WolfNet-Computing/WolfNet-65C02-WBC/Debug.jpg

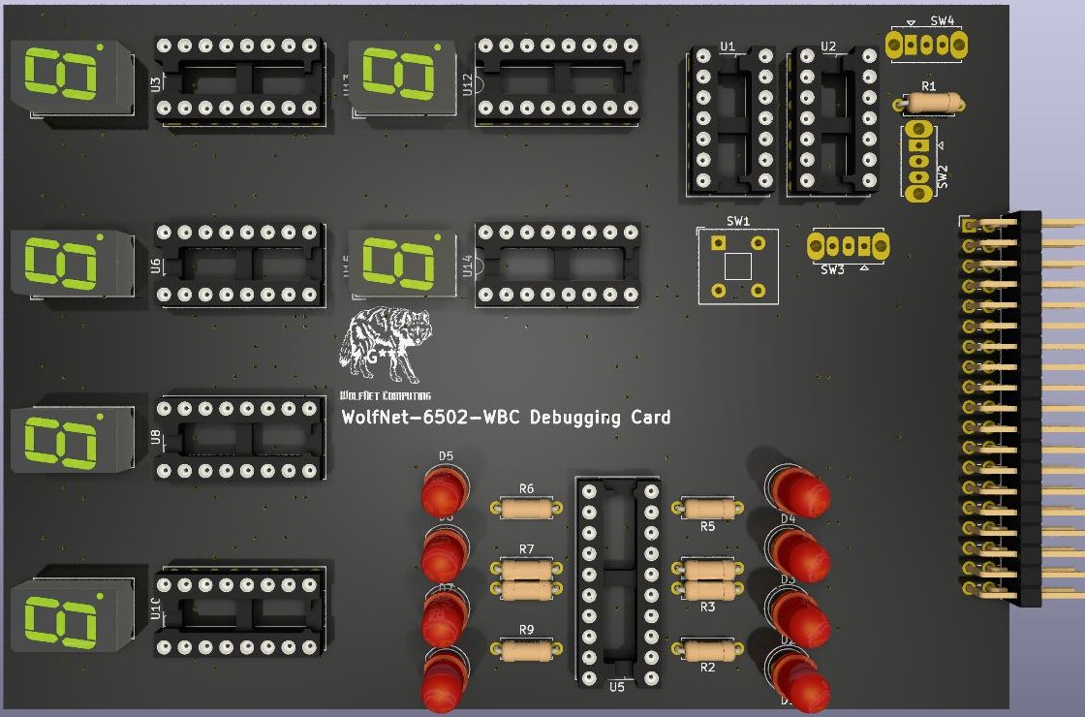
Debug.jpg
