WolfNet-Computing/WolfNet-65C02-WBC/Sound.jpg

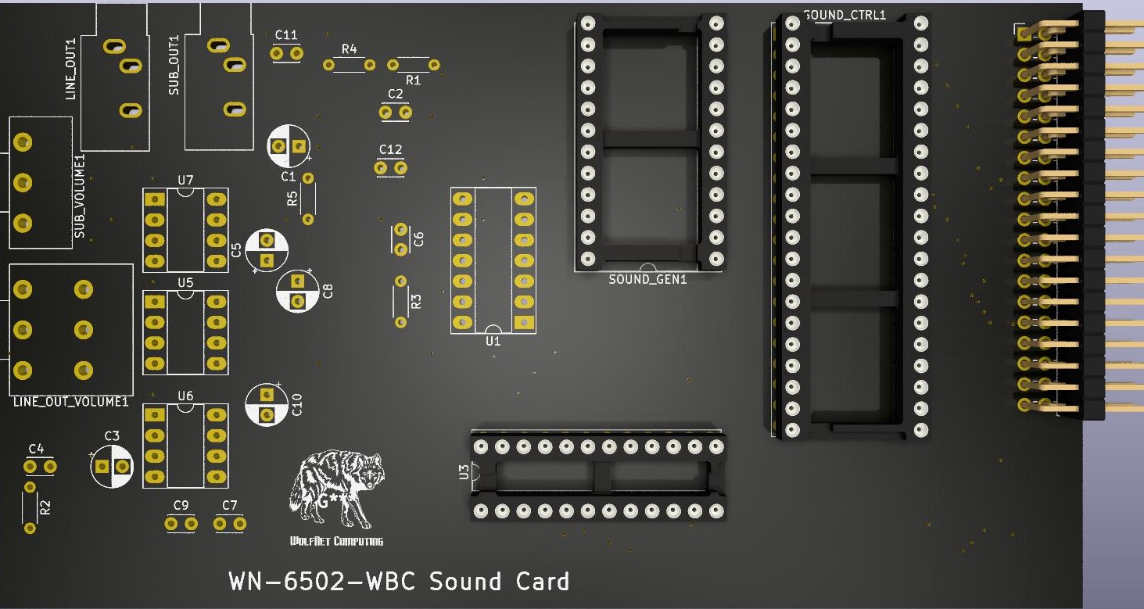
Sound.jpg
