WolfNet-Computing/WolfNet-65C02-WBC/README.md

[Pictures](./pictures.html)  
[Connector Pinouts](./pinouts.html)  
[Memory Map](./memory_map.html)  
[Thanks](./thanks.html)
