WolfNet-Computing/WolfNet-65C02-WBC/Motherboard.jpg

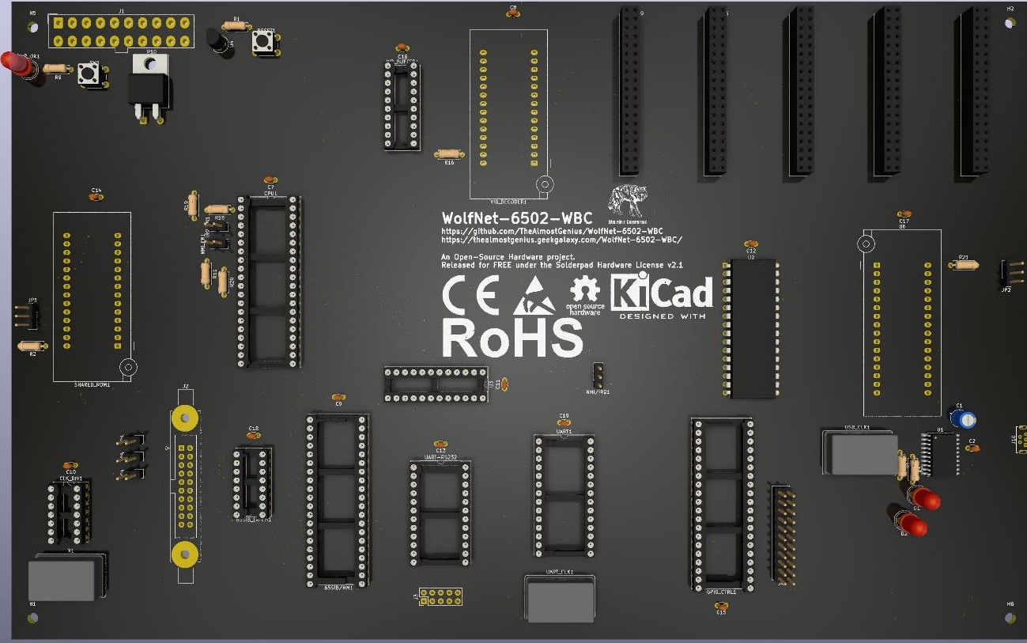
Motherboard.jpg
