WolfNet-Computing/WolfNet-65C02-WBC/Motherboard/Motherboard.kicad_pcb

## KiCad design Motherboard/Motherboard.kicad_pcb (2026-08-31)

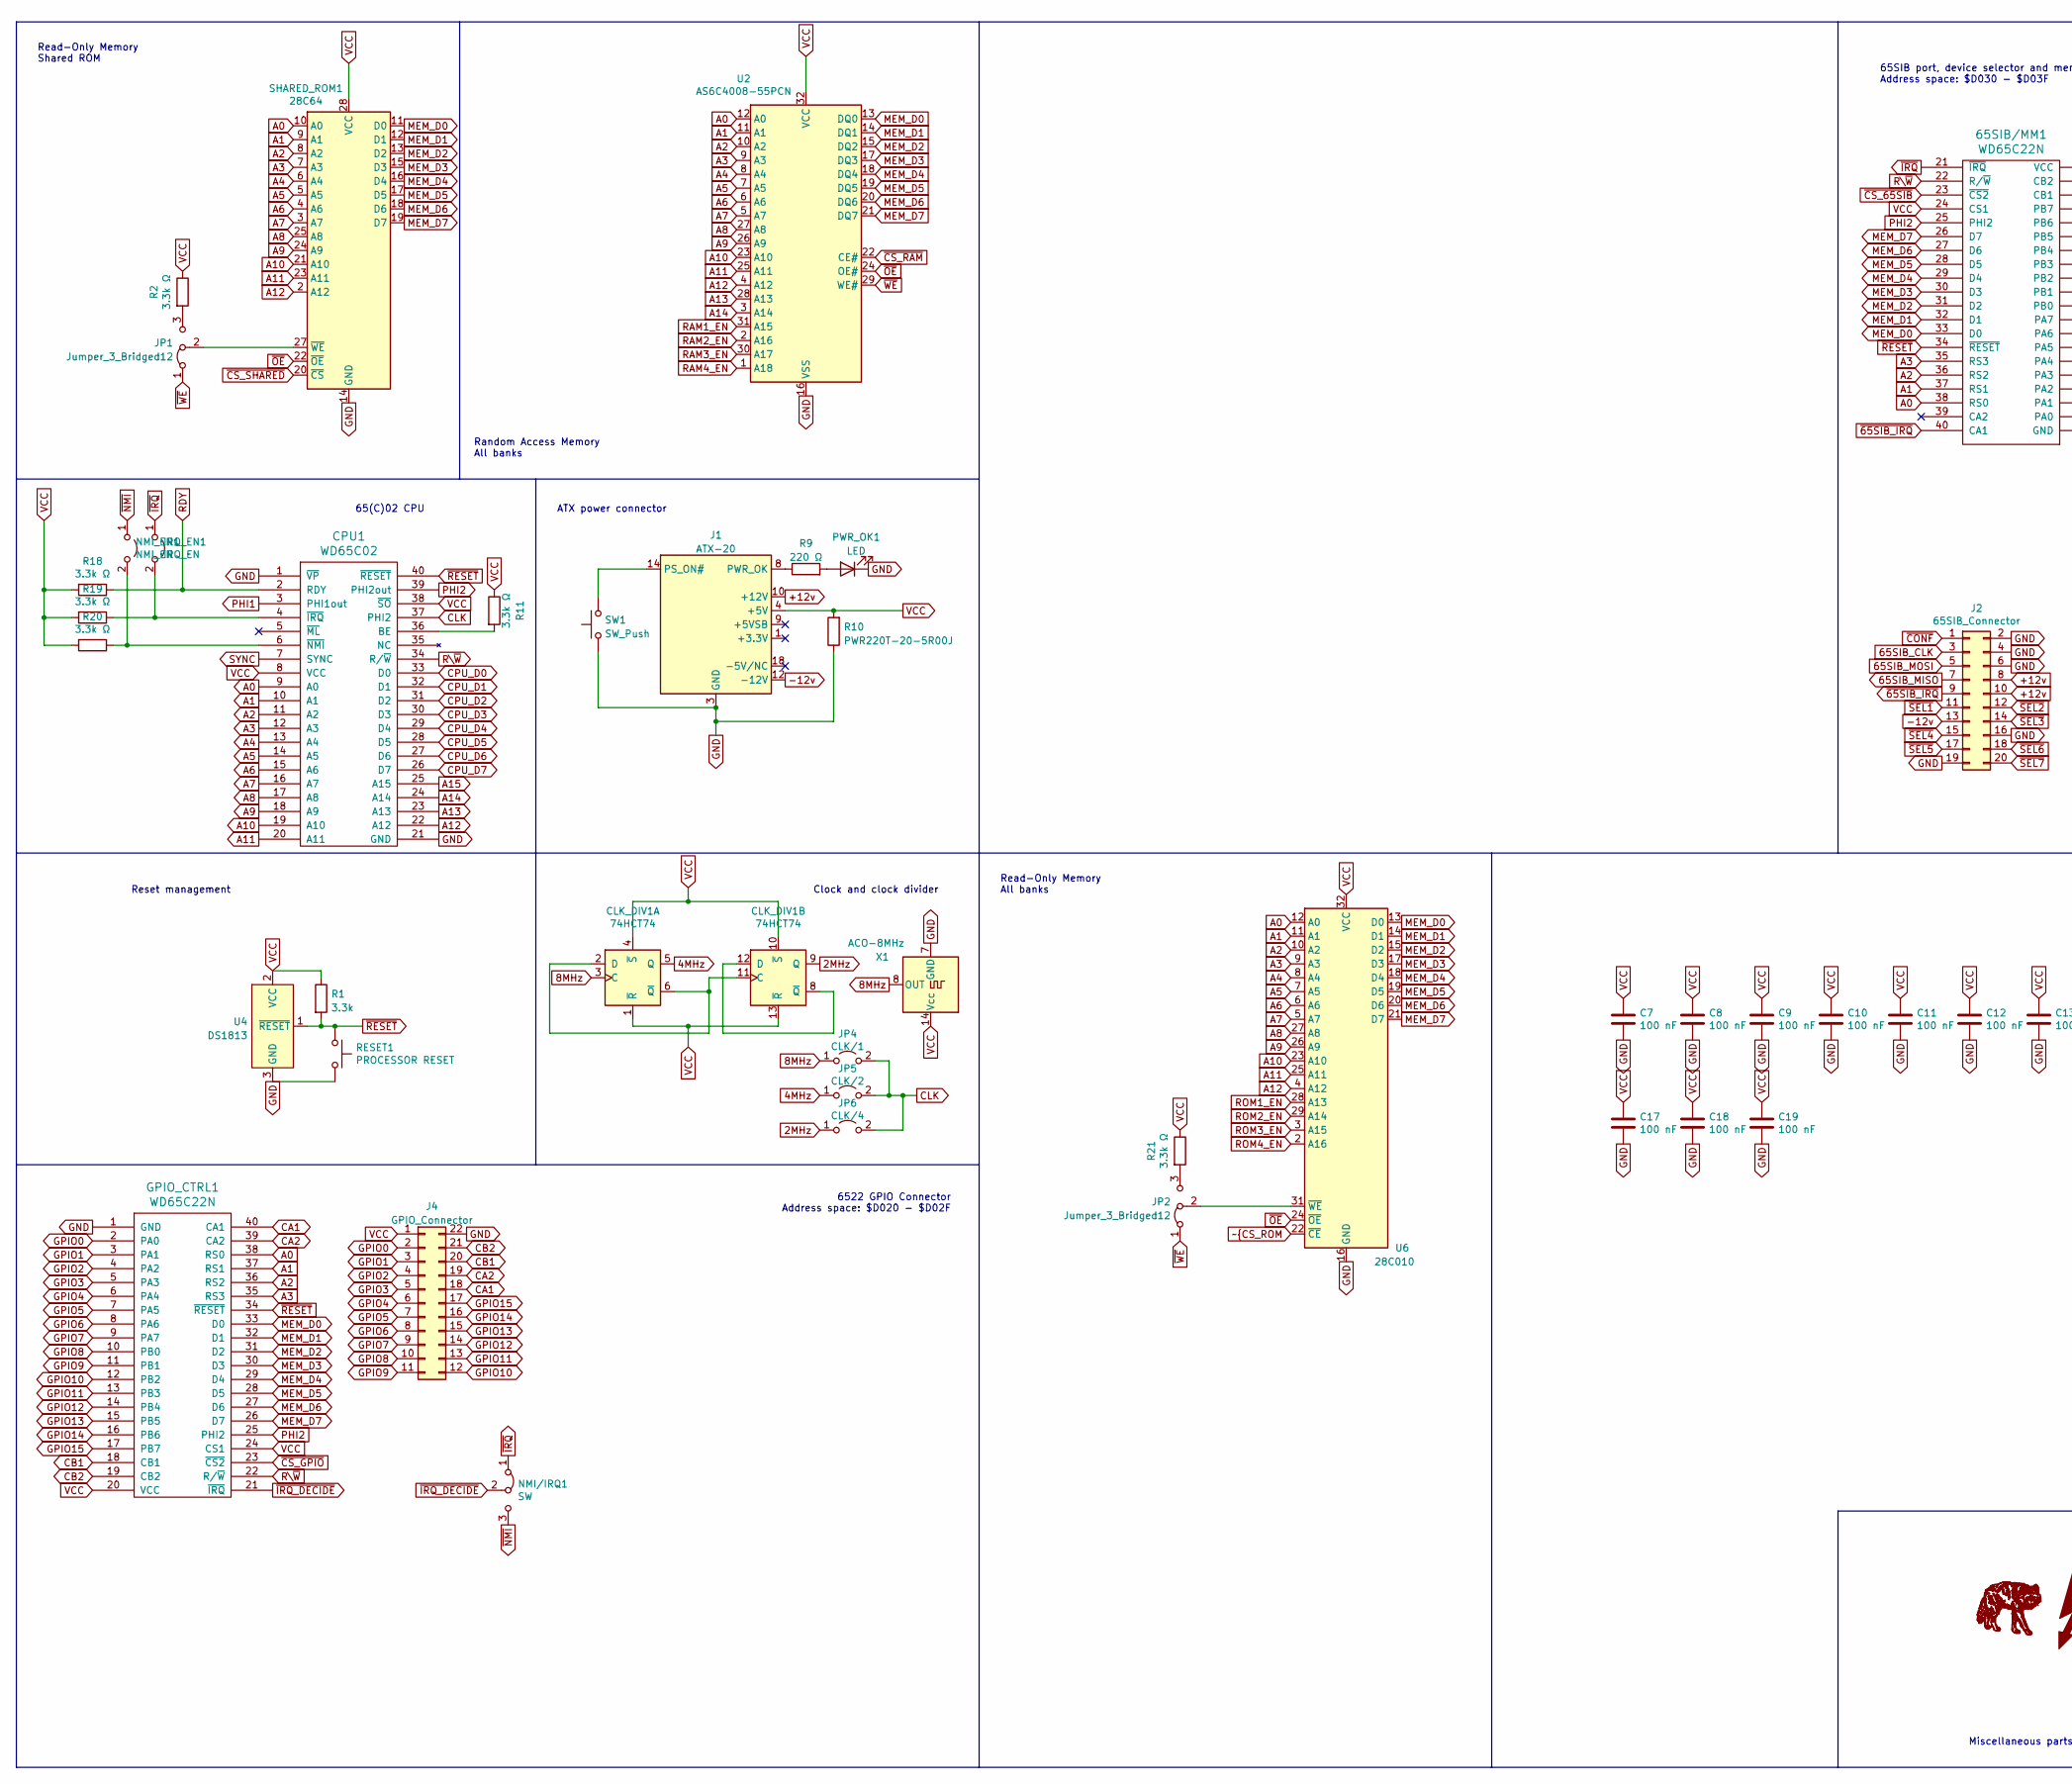
[picture p4: schematic Motherboard.kicad_sch, WolfNet 6502 WBC - Motherboard, part in row 1, column 1]

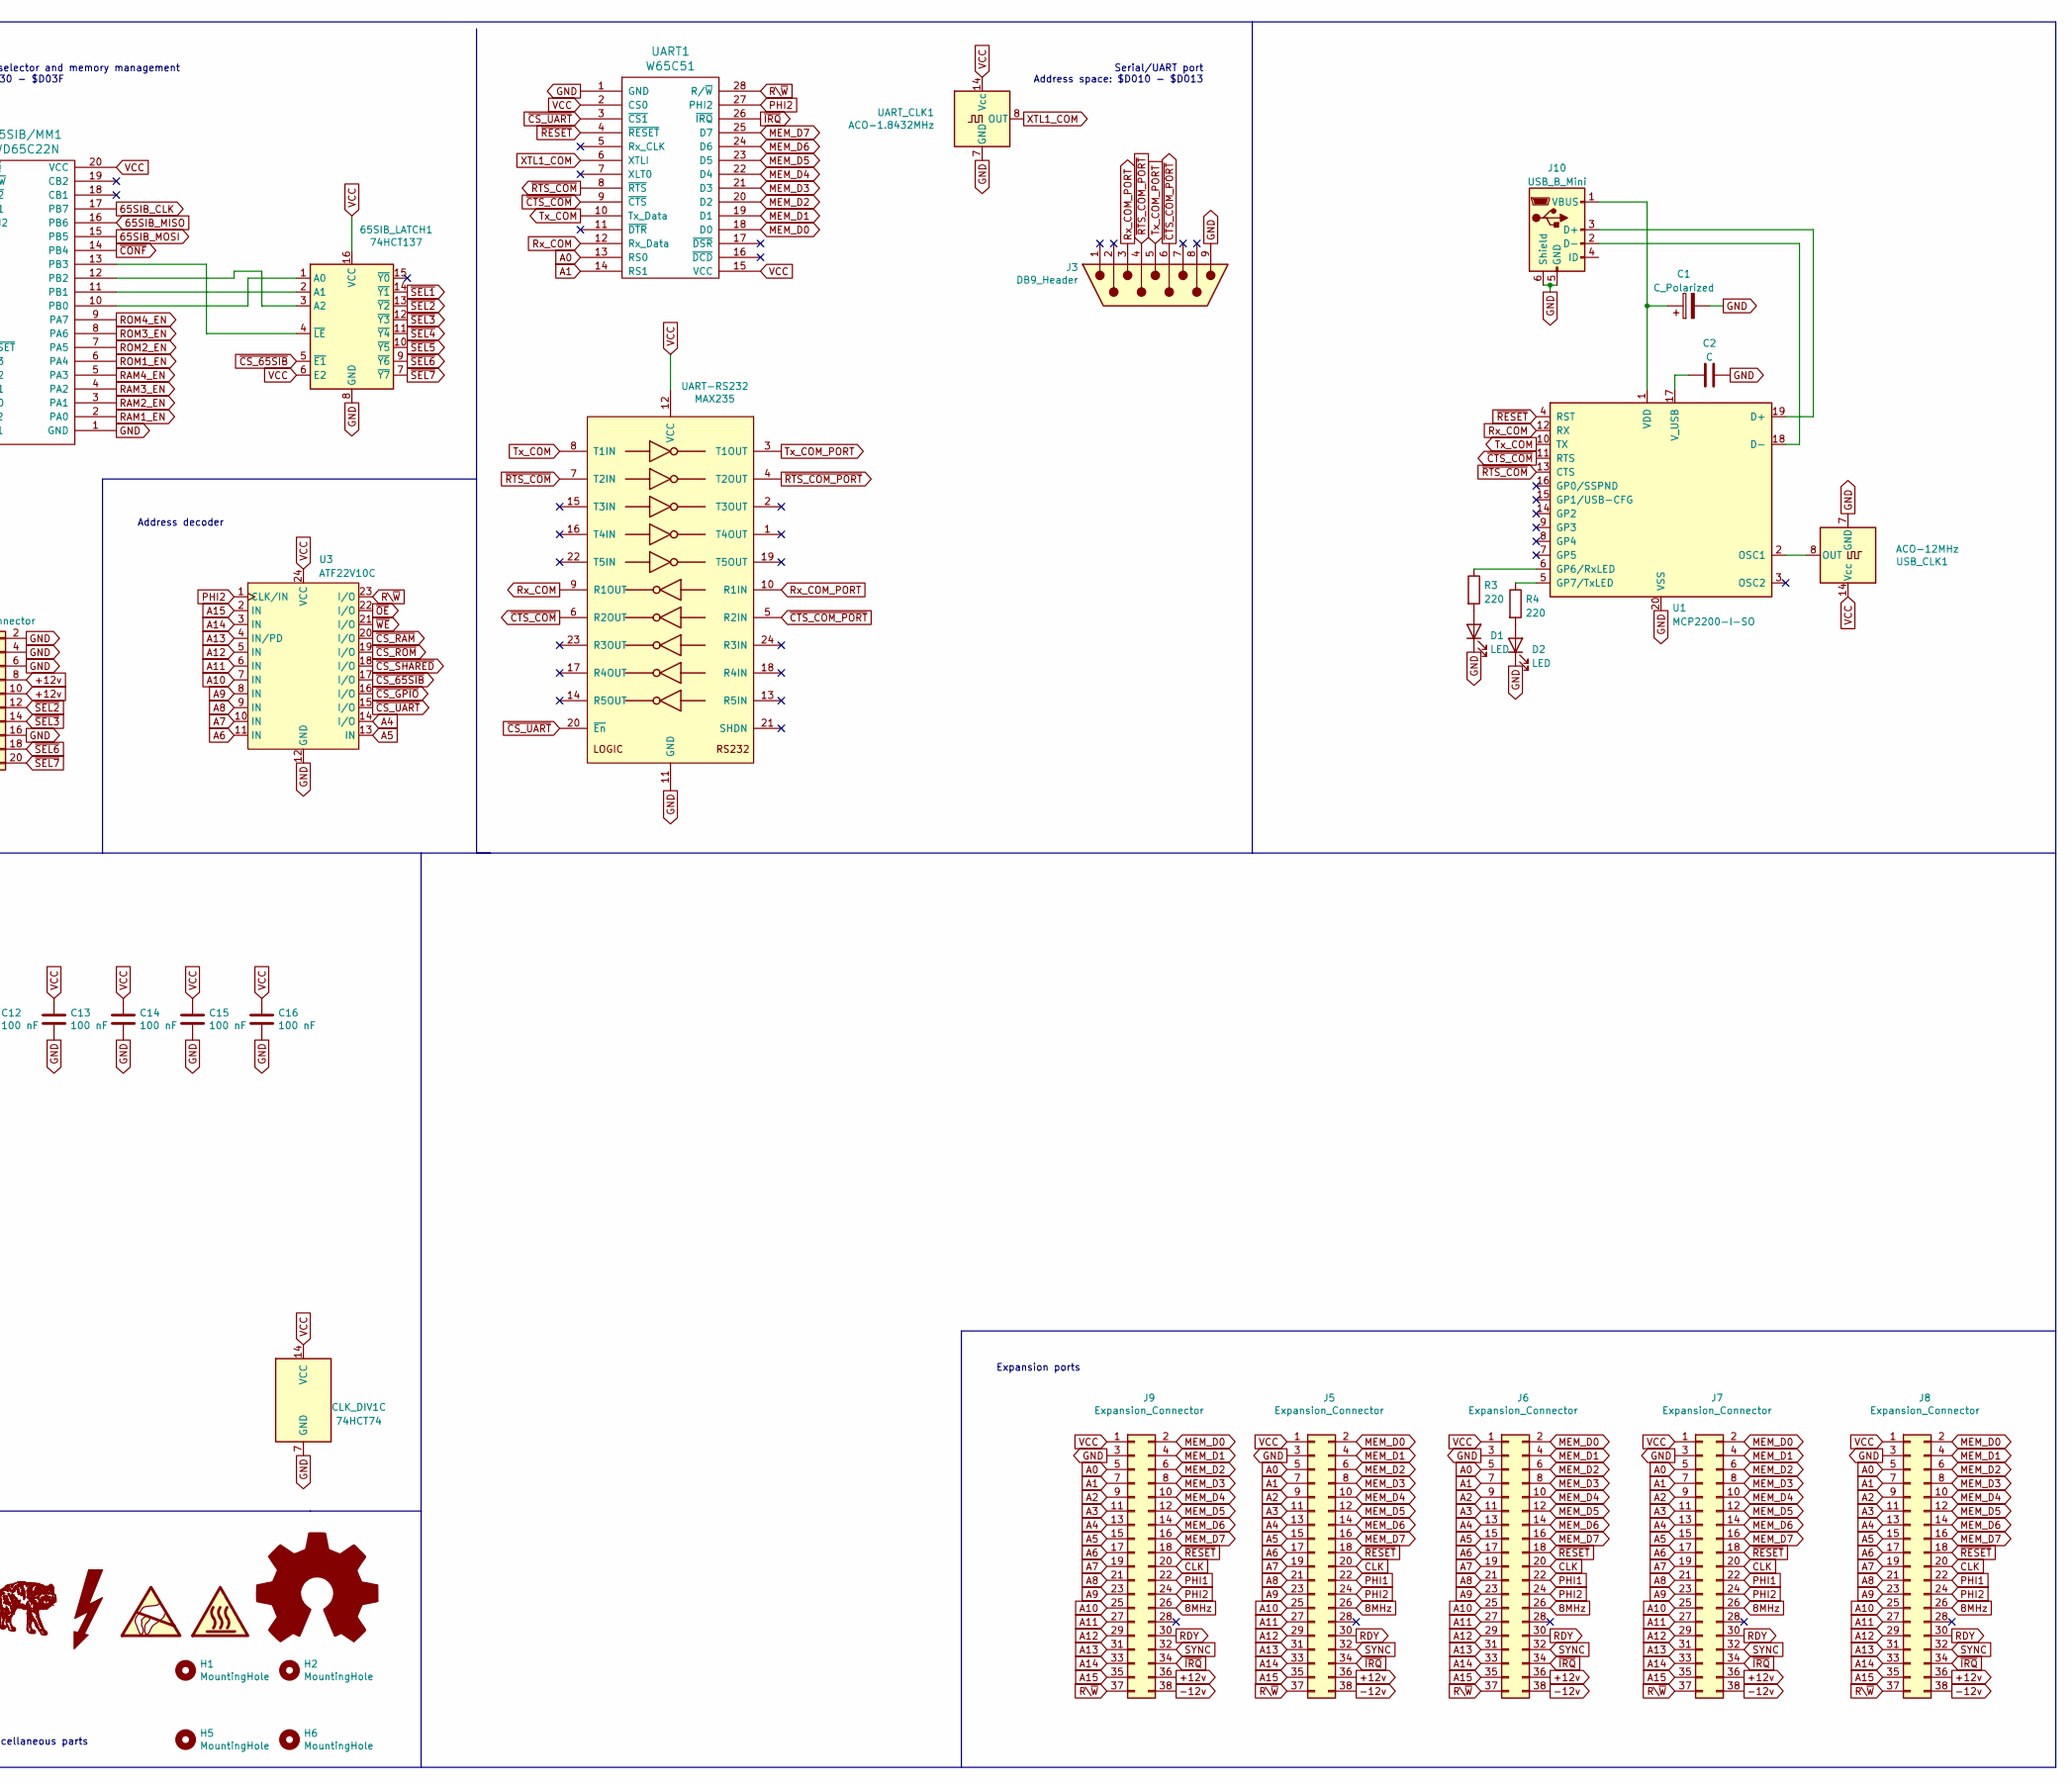
[picture p5: schematic Motherboard.kicad_sch, WolfNet 6502 WBC - Motherboard, part in row 1, column 2]

Parts:
65SIB/MM1: WD65C22N; DIP-40_W15.24mm_Socket_LongPads
65SIB_LATCH1: 74HCT137; DIP-16_W7.62mm_Socket_LongPads
C1: C_Polarized; CP_Radial_D5.0mm_P2.50mm
C2: C; C_Disc_D3.0mm_W1.6mm_P2.50mm
C7, C8, C9, C10, C11, C12, C13, C14, C15, C16, C17, C18, C19: 100 nF; C_Disc_D3.0mm_W1.6mm_P2.50mm
CLK_DIV1: 74HCT74; DIP-14_W7.62mm_Socket_LongPads
CPU1: WD65C02; DIP-40_W15.24mm_Socket_LongPads
D1, D2: LED; LED_D5.0mm
GPIO_CTRL1: WD65C22N; DIP-40_W15.24mm_Socket_LongPads
H1, H2, H5, H6: MountingHole; MountingHole_3.2mm_M3
IRQ_EN1: IRQ_EN; PinHeader_1x02_P2.54mm_Vertical
J1: ATX-20; Molex_Mini-Fit_Jr_5566-20A_2x10_P4.20mm_Vertical
J2: 65SIB_Connector; IDC-Header_2x10-1MP_P2.54mm_Latch6.5mm_Vertical
J3: DB9_Header
J4: GPIO_Connector; PinHeader_2x11_P2.54mm_Vertical
J5, J6, J7, J8, J9: Expansion_Connector; Expansion_Connector_Motherboard
J10: USB_B_Mini; USB_Mini-B_Tensility_54-00023_Vertical
JP1, JP2: Jumper_3_Bridged12; PinHeader_1x03_P2.54mm_Vertical
JP4: CLK/1; PinHeader_1x02_P2.54mm_Vertical
JP5: CLK/2; PinHeader_1x02_P2.54mm_Vertical
JP6: CLK/4; PinHeader_1x02_P2.54mm_Vertical
NMI/IRQ1: SW; PinHeader_1x03_P2.54mm_Vertical
NMI_EN1: NMI_EN; PinHeader_1x02_P2.54mm_Vertical
PWR_OK1: LED; LED_D5.0mm
R1: 3.3k; R_Axial_DIN0207_L6.3mm_D2.5mm_P7.62mm_Horizontal
R2, R11, R18, R19, R20, R21: 3.3k Ω; R_Axial_DIN0207_L6.3mm_D2.5mm_P7.62mm_Horizontal
R3, R4: 220; R_Axial_DIN0207_L6.3mm_D2.5mm_P7.62mm_Horizontal
R9: 220 Ω; R_Axial_DIN0207_L6.3mm_D2.5mm_P7.62mm_Horizontal
R10: PWR220T-20-5R00J; TO-220-2_Horizontal_TabDown
RESET1: PROCESSOR RESET; SW_PUSH_6mm_H4.3mm
SHARED_ROM1: 28C64; DIP_Socket-28_W11.9_W12.7_W15.24_W17.78_W18.5_3M_228-1277-0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
SW1: SW_Push; SW_PUSH_6mm
U1: MCP2200-I-SO; SOIC-20W_7.5x12.8mm_P1.27mm
U2: AS6C4008-55PCN; DIP-32_W15.24mm
U3: ATF22V10C; DIP-24_W7.62mm_Socket_LongPads
U4: DS1813; TO-92
U6: 28C010; DIP_Socket-32_W11.9_W12.7_W15.24_W17.78_W18.5_3M_232-1285-0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
UART1: W65C51; DIP-28_W15.24mm_Socket_LongPads
UART-RS232: MAX235; DIP-24_W15.24mm_Socket_LongPads
UART_CLK1: ACO-1.8432MHz; Oscillator_DIP-14
USB_CLK1: ACO-12MHz; Oscillator_DIP-14
X1: ACO-8MHz; Oscillator_DIP-14

Connections:
2MHz: CLK_DIV1.9 (Q), JP6.1 (A)
4MHz: CLK_DIV1.5 (Q), JP5.1 (A)
8MHz: CLK_DIV1.3 (C), J5.26, J6.26, J7.26, J8.26, J9.26, JP4.1 (A), X1.8 (OUT)
65SIB_CLK: 65SIB/MM1.17 (PB7), J2.3 (CLK)
65SIB_MISO: 65SIB/MM1.16 (PB6), J2.7 (MISO)
65SIB_MOSI: 65SIB/MM1.15 (PB5), J2.5 (MOSI)
+12v: J1.10 (+12V), J2.8 (12v), J2.10 (12v), J5.36, J6.36, J7.36, J8.36, J9.36
-12v: J1.12 (-12V), J2.13 (-12v), J5.38, J6.38, J7.38, J8.38, J9.38
A0: 65SIB/MM1.38 (RS0), CPU1.9 (A0), GPIO_CTRL1.38 (RS0), J5.5, J6.5, J7.5, J8.5, J9.5, SHARED_ROM1.10 (A0), U2.12 (A0), U6.12 (A0), UART1.13 (RS0)
A1: 65SIB/MM1.37 (RS1), CPU1.10 (A1), GPIO_CTRL1.37 (RS1), J5.7, J6.7, J7.7, J8.7, J9.7, SHARED_ROM1.9 (A1), U2.11 (A1), U6.11 (A1), UART1.14 (RS1)
A2: 65SIB/MM1.36 (RS2), CPU1.11 (A2), GPIO_CTRL1.36 (RS2), J5.9, J6.9, J7.9, J8.9, J9.9, SHARED_ROM1.8 (A2), U2.10 (A2), U6.10 (A2)
A3: 65SIB/MM1.35 (RS3), CPU1.12 (A3), GPIO_CTRL1.35 (RS3), J5.11, J6.11, J7.11, J8.11, J9.11, SHARED_ROM1.7 (A3), U2.9 (A3), U6.9 (A3)
A4: CPU1.13 (A4), J5.13, J6.13, J7.13, J8.13, J9.13, SHARED_ROM1.6 (A4), U2.8 (A4), U3.14 (I/O), U6.8 (A4)
A5: CPU1.14 (A5), J5.15, J6.15, J7.15, J8.15, J9.15, SHARED_ROM1.5 (A5), U2.7 (A5), U3.13 (IN), U6.7 (A5)
A6: CPU1.15 (A6), J5.17, J6.17, J7.17, J8.17, J9.17, SHARED_ROM1.4 (A6), U2.6 (A6), U3.11 (IN), U6.6 (A6)
A7: CPU1.16 (A7), J5.19, J6.19, J7.19, J8.19, J9.19, SHARED_ROM1.3 (A7), U2.5 (A7), U3.10 (IN), U6.5 (A7)
A8: CPU1.17 (A8), J5.21, J6.21, J7.21, J8.21, J9.21, SHARED_ROM1.25 (A8), U2.27 (A8), U3.9 (IN), U6.27 (A8)
A9: CPU1.18 (A9), J5.23, J6.23, J7.23, J8.23, J9.23, SHARED_ROM1.24 (A9), U2.26 (A9), U3.8 (IN), U6.26 (A9)
A10: CPU1.19 (A10), J5.25, J6.25, J7.25, J8.25, J9.25, SHARED_ROM1.21 (A10), U2.23 (A10), U3.7 (IN), U6.23 (A10)
A11: CPU1.20 (A11), J5.27, J6.27, J7.27, J8.27, J9.27, SHARED_ROM1.23 (A11), U2.25 (A11), U3.6 (IN), U6.25 (A11)
A12: CPU1.22 (A12), J5.29, J6.29, J7.29, J8.29, J9.29, SHARED_ROM1.2 (A12), U2.4 (A12), U3.5 (IN), U6.4 (A12)
A13: CPU1.23 (A13), J5.31, J6.31, J7.31, J8.31, J9.31, U2.28 (A13), U3.4 (IN/PD)
A14: CPU1.24 (A14), J5.33, J6.33, J7.33, J8.33, J9.33, U2.3 (A14), U3.3 (IN)
A15: CPU1.25 (A15), J5.35, J6.35, J7.35, J8.35, J9.35, U3.2 (IN)
CA1: GPIO_CTRL1.40 (CA1), J4.18
CA2: GPIO_CTRL1.39 (CA2), J4.19
CB1: GPIO_CTRL1.18 (CB1), J4.20
CB2: GPIO_CTRL1.19 (CB2), J4.21
CLK: CPU1.37 (PHI2), J5.20, J6.20, J7.20, J8.20, J9.20, JP4.2 (B), JP5.2 (B), JP6.2 (B)
CPU_D0: CPU1.33 (D0)
CPU_D1: CPU1.32 (D1)
CPU_D2: CPU1.31 (D2)
CPU_D3: CPU1.30 (D3)
CPU_D4: CPU1.29 (D4)
CPU_D5: CPU1.28 (D5)
CPU_D6: CPU1.27 (D6)
CPU_D7: CPU1.26 (D7)
GND: 65SIB/MM1.1 (GND), 65SIB_LATCH1.8 (GND), C1.2, C2.2, C7.2, C8.2, C9.2, C10.2, C11.2, C12.2, C13.2, C14.2, C15.2, C16.2, C17.2, C18.2, C19.2, CLK_DIV1.7 (GND), CPU1.1 (~VP), CPU1.21 (GND), D1.1 (K), D2.1 (K), GPIO_CTRL1.1 (GND), J1.3 (GND), J1.5 (GND), J1.7 (GND), J1.13 (GND), J1.15 (GND), J1.16 (GND), J1.17 (GND), J2.2 (GND), J2.4 (GND), J2.6 (eGND), J2.16 (GND), J2.19 (GND), J3.9 (5), J4.22, J5.3, J6.3, J7.3, J8.3, J9.3, J10.5 (GND), J10.6 (Shield), PWR_OK1.1 (K), R10.1, RESET1.2, SHARED_ROM1.14 (GND), SW1.1, U1.20 (VSS), U2.16 (VSS), U3.12 (GND), U4.3 (GND), U6.16 (GND), UART1.1 (GND), UART-RS232.11 (GND), UART_CLK1.7 (GND), USB_CLK1.7 (GND), X1.7 (GND)
GPIO0: GPIO_CTRL1.2 (PA0), J4.2
GPIO1: GPIO_CTRL1.3 (PA1), J4.3
GPIO2: GPIO_CTRL1.4 (PA2), J4.4
GPIO3: GPIO_CTRL1.5 (PA3), J4.5
GPIO4: GPIO_CTRL1.6 (PA4), J4.6
GPIO5: GPIO_CTRL1.7 (PA5), J4.7
GPIO6: GPIO_CTRL1.8 (PA6), J4.8
GPIO7: GPIO_CTRL1.9 (PA7), J4.9
GPIO8: GPIO_CTRL1.10 (PB0), J4.10
GPIO9: GPIO_CTRL1.11 (PB1), J4.11
GPIO10: GPIO_CTRL1.12 (PB2), J4.12
GPIO11: GPIO_CTRL1.13 (PB3), J4.13
GPIO12: GPIO_CTRL1.14 (PB4), J4.14
GPIO13: GPIO_CTRL1.15 (PB5), J4.15
GPIO14: GPIO_CTRL1.16 (PB6), J4.16
GPIO15: GPIO_CTRL1.17 (PB7), J4.17
MEM_D0: 65SIB/MM1.33 (D0), GPIO_CTRL1.33 (D0), J5.2, J6.2, J7.2, J8.2, J9.2, SHARED_ROM1.11 (D0), U2.13 (DQ0), U6.13 (D0), UART1.18 (D0)
MEM_D1: 65SIB/MM1.32 (D1), GPIO_CTRL1.32 (D1), J5.4, J6.4, J7.4, J8.4, J9.4, SHARED_ROM1.12 (D1), U2.14 (DQ1), U6.14 (D1), UART1.19 (D1)
MEM_D2: 65SIB/MM1.31 (D2), GPIO_CTRL1.31 (D2), J5.6, J6.6, J7.6, J8.6, J9.6, SHARED_ROM1.13 (D2), U2.15 (DQ2), U6.15 (D2), UART1.20 (D2)
MEM_D3: 65SIB/MM1.30 (D3), GPIO_CTRL1.30 (D3), J5.8, J6.8, J7.8, J8.8, J9.8, SHARED_ROM1.15 (D3), U2.17 (DQ3), U6.17 (D3), UART1.21 (D3)
MEM_D4: 65SIB/MM1.29 (D4), GPIO_CTRL1.29 (D4), J5.10, J6.10, J7.10, J8.10, J9.10, SHARED_ROM1.16 (D4), U2.18 (DQ4), U6.18 (D4), UART1.22 (D4)
MEM_D5: 65SIB/MM1.28 (D5), GPIO_CTRL1.28 (D5), J5.12, J6.12, J7.12, J8.12, J9.12, SHARED_ROM1.17 (D5), U2.19 (DQ5), U6.19 (D5), UART1.23 (D5)
MEM_D6: 65SIB/MM1.27 (D6), GPIO_CTRL1.27 (D6), J5.14, J6.14, J7.14, J8.14, J9.14, SHARED_ROM1.18 (D6), U2.20 (DQ6), U6.20 (D6), UART1.24 (D6)
MEM_D7: 65SIB/MM1.26 (D7), GPIO_CTRL1.26 (D7), J5.16, J6.16, J7.16, J8.16, J9.16, SHARED_ROM1.19 (D7), U2.21 (DQ7), U6.21 (D7), UART1.25 (D7)
unnamed: 65SIB/MM1.10 (PB0), 65SIB_LATCH1.1 (A0)
unnamed: 65SIB/MM1.11 (PB1), 65SIB_LATCH1.2 (A1)
unnamed: 65SIB/MM1.12 (PB2), 65SIB_LATCH1.3 (A2)
unnamed: 65SIB/MM1.13 (PB3), 65SIB_LATCH1.4 (~LE)
unnamed: CLK_DIV1.2 (D), CLK_DIV1.6 (~Q), CLK_DIV1.11 (C)
unnamed: CLK_DIV1.8 (~Q), CLK_DIV1.12 (D)
unnamed: CPU1.36 (BE), R11.2
unnamed: CPU1.4 (~IRQ), IRQ_EN1.2 (B), R19.1
unnamed: CPU1.6 (~NMI), NMI_EN1.2 (B), R20.1
unnamed: D1.2 (A), R3.2
unnamed: D2.2 (A), R4.2
unnamed: J1.14 (PS_ON#), SW1.2
unnamed: J1.8 (PWR_OK), R9.1
unnamed: J10.3 (D+), U1.19 (D+)
unnamed: J10.2 (D-), U1.18 (D-)
unnamed: C1.1, J10.1 (VBUS), U1.1 (VDD)
unnamed: JP1.3 (B), R2.2
unnamed: JP1.2 (C), SHARED_ROM1.27 (~WE)
unnamed: JP2.3 (B), R21.2
unnamed: JP2.2 (C), U6.31 (~WE)
unnamed: PWR_OK1.2 (A), R9.2
unnamed: R3.1, U1.6 (GP6/RxLED)
unnamed: R4.1, U1.5 (GP7/TxLED)
unnamed: U1.2 (OSC1), USB_CLK1.8 (OUT)
unnamed: C2.1, U1.17 (V_USB)
PHI1: CPU1.3 (PHI1out), J5.22, J6.22, J7.22, J8.22, J9.22
PHI2: 65SIB/MM1.25 (PHI2), CPU1.39 (PHI2out), GPIO_CTRL1.25 (PHI2), J5.24, J6.24, J7.24, J8.24, J9.24, U3.1 (CLK/IN), UART1.27 (PHI2)
RAM1_EN: 65SIB/MM1.2 (PA0), U2.31 (A15)
RAM2_EN: 65SIB/MM1.3 (PA1), U2.2 (A16)
RAM3_EN: 65SIB/MM1.4 (PA2), U2.30 (A17)
RAM4_EN: 65SIB/MM1.5 (PA3), U2.1 (A18)
RDY: CPU1.2 (RDY), J5.30, J6.30, J7.30, J8.30, J9.30, R18.1
ROM1_EN: 65SIB/MM1.6 (PA4), U6.28 (A13)
ROM2_EN: 65SIB/MM1.7 (PA5), U6.29 (A14)
ROM3_EN: 65SIB/MM1.8 (PA6), U6.3 (A15)
ROM4_EN: 65SIB/MM1.9 (PA7), U6.2 (A16)
R\~W: 65SIB/MM1.22 (R/~W), CPU1.34 (R/~W), GPIO_CTRL1.22 (R/~W), J5.37, J6.37, J7.37, J8.37, J9.37, U3.23 (I/O), UART1.28 (R/~W)
Rx_COM: U1.12 (RX), UART1.12 (Rx_Data), UART-RS232.9 (R1OUT)
Rx_COM_PORT: J3.3 (2), UART-RS232.10 (R1IN)
SYNC: CPU1.7 (SYNC), J5.32, J6.32, J7.32, J8.32, J9.32
Tx_COM: U1.10 (TX), UART1.10 (Tx_Data), UART-RS232.8 (T1IN)
Tx_COM_PORT: J3.5 (3), UART-RS232.3 (T1OUT)
VCC: 65SIB/MM1.20 (VCC), 65SIB/MM1.24 (CS1), 65SIB_LATCH1.6 (E2), 65SIB_LATCH1.16 (VCC), C7.1, C8.1, C9.1, C10.1, C11.1, C12.1, C13.1, C14.1, C15.1, C16.1, C17.1, C18.1, C19.1, CLK_DIV1.1 (~R), CLK_DIV1.4 (~S), CLK_DIV1.10 (~S), CLK_DIV1.13 (~R), CLK_DIV1.14 (VCC), CPU1.8 (VCC), CPU1.38 (~SO), GPIO_CTRL1.20 (VCC), GPIO_CTRL1.24 (CS1), J1.4 (+5V), J1.6 (+5V), J1.19 (+5V), J1.20 (+5V), J4.1, J5.1, J6.1, J7.1, J8.1, J9.1, R1.1, R2.1, R10.2, R11.1, R18.2, R19.2, R20.2, R21.1, SHARED_ROM1.28 (VCC), U2.32 (VCC), U3.24 (VCC), U4.2 (VCC), U6.32 (VCC), UART1.2 (CS0), UART1.15 (VCC), UART-RS232.12 (VCC), UART_CLK1.14 (Vcc), USB_CLK1.14 (Vcc), X1.14 (Vcc)
XTL1_COM: UART1.6 (XTLI), UART_CLK1.8 (OUT)
~65SIB_IRQ: 65SIB/MM1.40 (CA1), J2.9 (IRO\)
~CONF: 65SIB/MM1.14 (PB4), J2.1 (CONF\)
~CS_65SIB: 65SIB/MM1.23 (~CS2), 65SIB_LATCH1.5 (~E1), U3.17 (I/O)
~CS_GPIO: GPIO_CTRL1.23 (~CS2), U3.16 (I/O)
~CS_RAM: U2.22 (CE#), U3.20 (I/O)
~{CS_ROM: U6.22 (~CE)
~CS_ROM: U3.19 (I/O)
~CS_SHARED: SHARED_ROM1.20 (~CS), U3.18 (I/O)
~CS_UART: U3.15 (I/O), UART1.3 (~CS1), UART-RS232.20 (~En)
~CTS_COM_PORT: J3.6 (8), UART-RS232.5 (R2IN)
~CTS_COM: U1.11 (RTS), UART1.9 (~CTS), UART-RS232.6 (R2OUT)
~IRQ_DECIDE: GPIO_CTRL1.21 (~IRQ), NMI/IRQ1.2 (C)
~IRQ: 65SIB/MM1.21 (~IRQ), IRQ_EN1.1 (A), J5.34, J6.34, J7.34, J8.34, J9.34, NMI/IRQ1.1 (A), UART1.26 (~IRQ)
~NMI: NMI/IRQ1.3 (B), NMI_EN1.1 (A)
~OE: SHARED_ROM1.22 (~OE), U2.24 (OE#), U3.22 (I/O), U6.24 (~OE)
~RESET: 65SIB/MM1.34 (~RESET), CPU1.40 (~RESET), GPIO_CTRL1.34 (~RESET), J5.18, J6.18, J7.18, J8.18, J9.18, R1.2, RESET1.1, U1.4 (RST), U4.1 (~RESET), UART1.4 (~RESET)
~RTS_COM_PORT: J3.4 (7), UART-RS232.4 (T2OUT)
~RTS_COM: U1.13 (CTS), UART1.8 (~RTS), UART-RS232.7 (T2IN)
~SEL1: 65SIB_LATCH1.14 (~Y1), J2.11 (SEL1\)
~SEL2: 65SIB_LATCH1.13 (~Y2), J2.12 (SEL2\)
~SEL3: 65SIB_LATCH1.12 (~Y3), J2.14 (SEL3\)
~SEL4: 65SIB_LATCH1.11 (~Y4), J2.15 (SEL4\)
~SEL5: 65SIB_LATCH1.10 (~Y5), J2.17 (SEL5\)
~SEL6: 65SIB_LATCH1.9 (~Y6), J2.18 (SEL6\)
~SEL7: 65SIB_LATCH1.7 (~Y7), J2.20 (SEL7\)
~WE: JP1.1 (A), JP2.1 (A), U2.29 (WE#), U3.21 (I/O)

Notes on the sheet:
ATX power connector
Expansion ports
Clock and clock divider
Miscellaneous parts
Serial/UART port Address space: $D010 - $D013
65(C)02 CPU
65SIB port, device selector and memory management Address space: $D030 - $D03F
Read-Only Memory All banks
Read-Only Memory Shared ROM
6522 GPIO Connector Address space: $D020 - $D02F
Random Access Memory All banks
Reset management
Address decoder

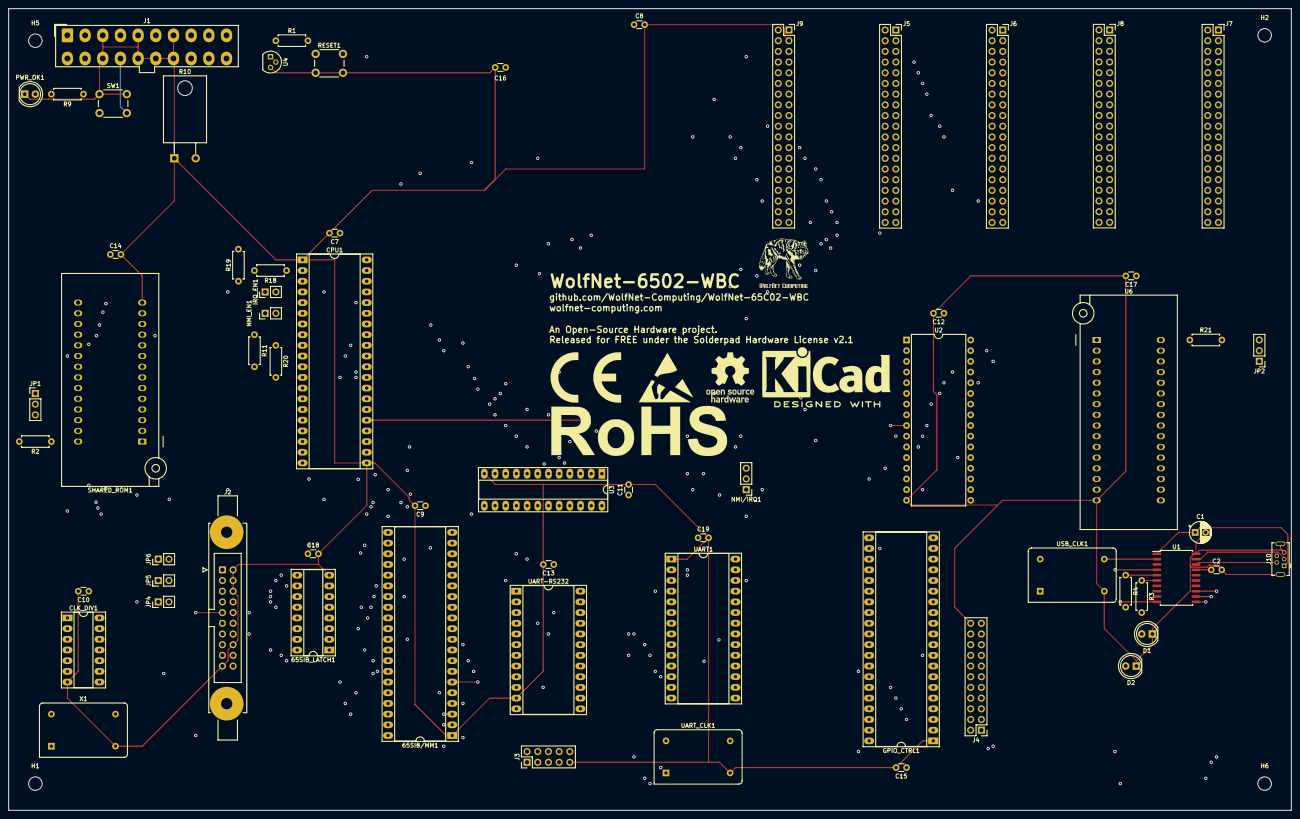
[picture p6: board Motherboard.kicad_pcb from above]

Board: 8 copper layers, 304.8 x 190.5 mm, 69 parts (0 on the bottom side), 122 nets.
