WolfNet-Computing/WolfNet-65C02-WBC/Sound/Sound.kicad_pcb

## KiCad design Sound/Sound.kicad_pcb (2026-08-31)

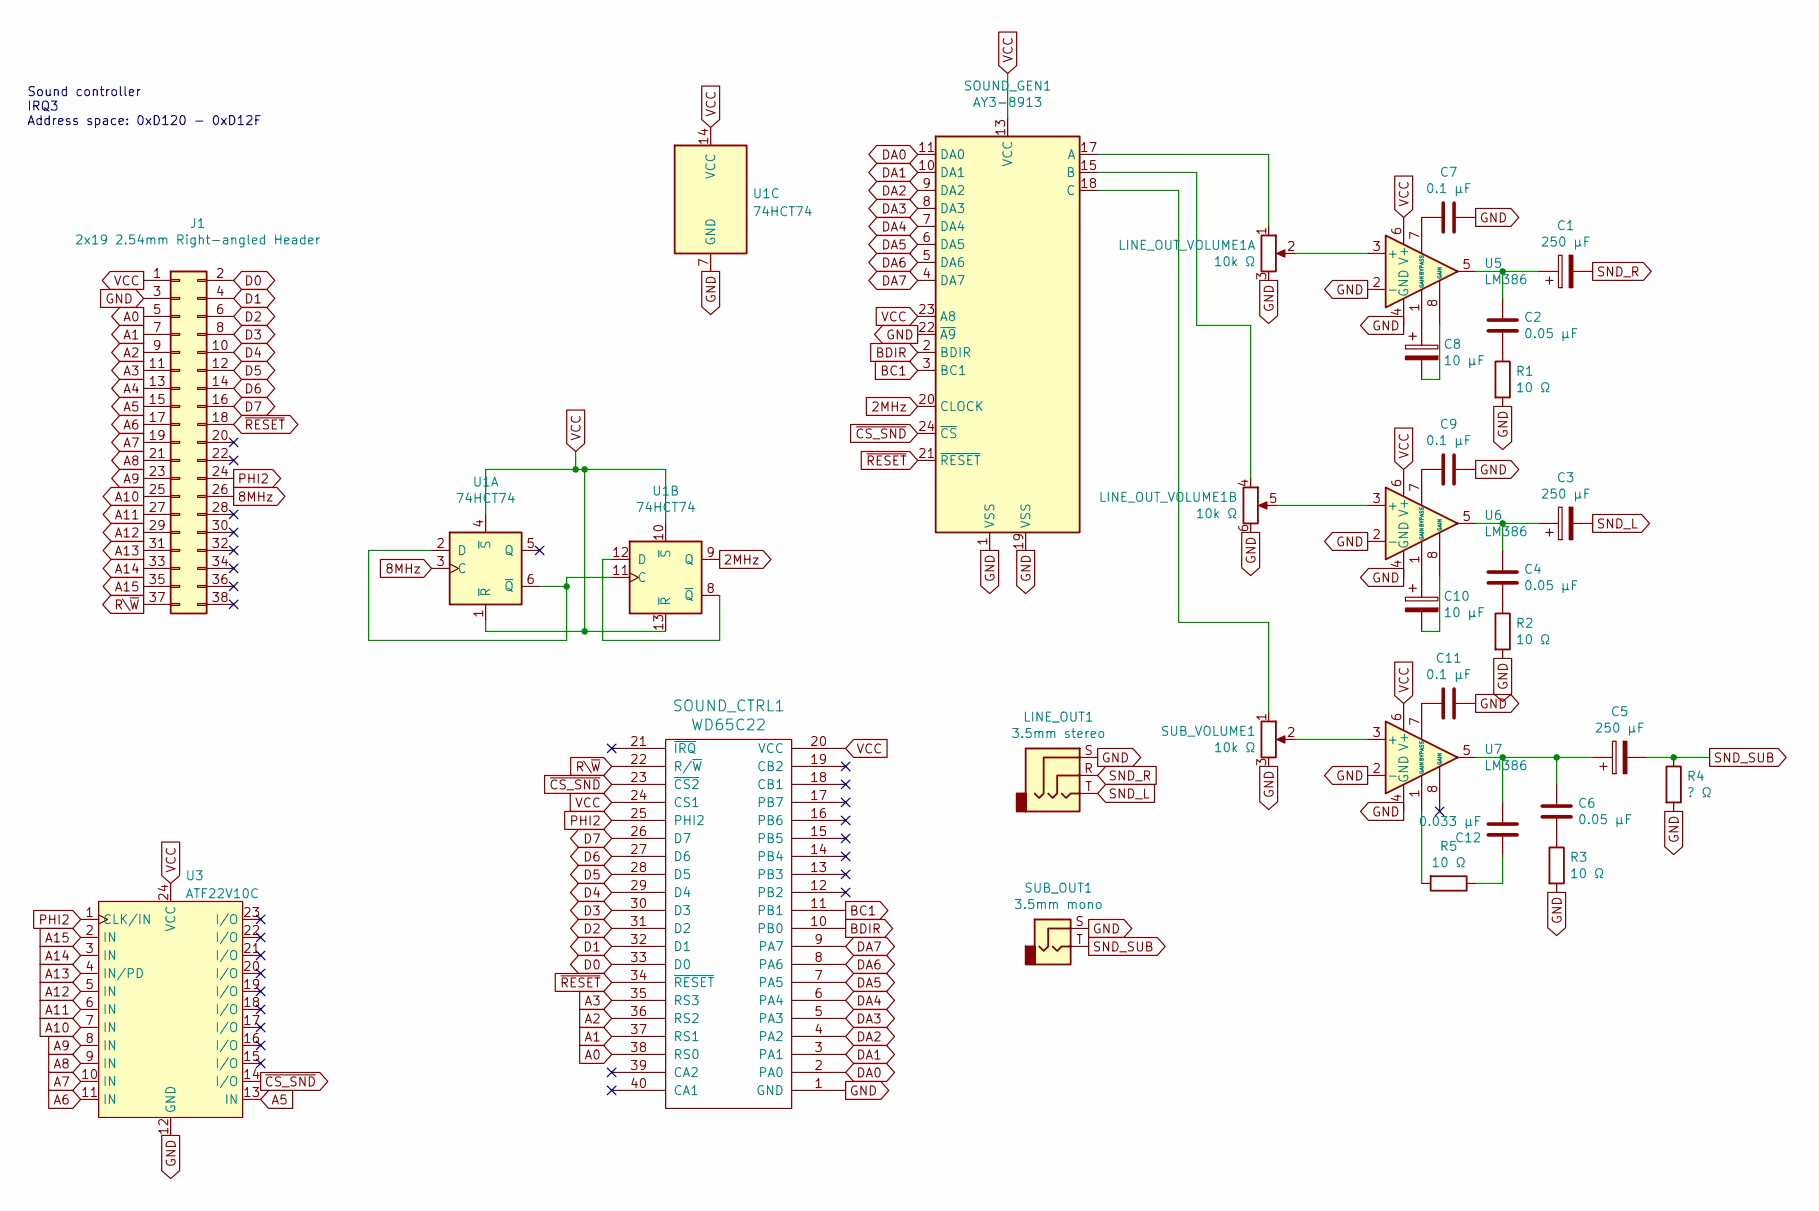
[picture p7: schematic Sound.kicad_sch, WolfNet 6502 WBC - Sound Card]

Parts:
C1, C3, C5: 250 µF; CP_Radial_D5.0mm_P2.50mm
C2, C4, C6: 0.05 µF; C_Disc_D3.0mm_W2.0mm_P2.50mm
C7, C9, C11: 0.1 µF; C_Disc_D3.0mm_W2.0mm_P2.50mm
C8, C10: 10 µF; CP_Radial_D5.0mm_P2.50mm
C12: 0.033 µF; C_Disc_D3.0mm_W2.0mm_P2.50mm
J1: 2x19 2.54mm Right-angled Header; Expansion_Connector_Board
LINE_OUT1: 3.5mm stereo; Jack_3.5mm_CUI_SJ1-3533NG_Horizontal
LINE_OUT_VOLUME1: 10k Ω; Potentiometer_Piher_T-16H_Double_Horizontal
R1, R2, R3, R5: 10 Ω; R_Axial_DIN0204_L3.6mm_D1.6mm_P5.08mm_Horizontal
R4: ? Ω; R_Axial_DIN0204_L3.6mm_D1.6mm_P5.08mm_Horizontal
SOUND_CTRL1: WD65C22; DIP-40_W15.24mm_Socket_LongPads
SOUND_GEN1: AY3-8913; DIP-24_W15.24mm_Socket_LongPads
SUB_OUT1: 3.5mm mono; Jack_3.5mm_CUI_SJ1-3533NG_Horizontal
SUB_VOLUME1: 10k Ω; Potentiometer_Piher_T-16H_Single_Horizontal
U1: 74HCT74; DIP-14_W7.62mm_Socket_LongPads
U3: ATF22V10C; DIP-24_W7.62mm_Socket_LongPads
U5, U6, U7: LM386; DIP-8_W7.62mm_Socket_LongPads

Connections:
2MHz: SOUND_GEN1.20 (CLOCK), U1.9 (Q)
8MHz: J1.26, U1.3 (C)
A0: J1.5, SOUND_CTRL1.38 (RS0)
A1: J1.7, SOUND_CTRL1.37 (RS1)
A2: J1.9, SOUND_CTRL1.36 (RS2)
A3: J1.11, SOUND_CTRL1.35 (RS3)
A4: J1.13
A5: J1.15, U3.13 (IN)
A6: J1.17, U3.11 (IN)
A7: J1.19, U3.10 (IN)
A8: J1.21, U3.9 (IN)
A9: J1.23, U3.8 (IN)
A10: J1.25, U3.7 (IN)
A11: J1.27, U3.6 (IN)
A12: J1.29, U3.5 (IN)
A13: J1.31, U3.4 (IN/PD)
A14: J1.33, U3.3 (IN)
A15: J1.35, U3.2 (IN)
BC1: SOUND_CTRL1.11 (PB1), SOUND_GEN1.3 (BC1)
BDIR: SOUND_CTRL1.10 (PB0), SOUND_GEN1.2 (BDIR)
D0: J1.2, SOUND_CTRL1.33 (D0)
D1: J1.4, SOUND_CTRL1.32 (D1)
D2: J1.6, SOUND_CTRL1.31 (D2)
D3: J1.8, SOUND_CTRL1.30 (D3)
D4: J1.10, SOUND_CTRL1.29 (D4)
D5: J1.12, SOUND_CTRL1.28 (D5)
D6: J1.14, SOUND_CTRL1.27 (D6)
D7: J1.16, SOUND_CTRL1.26 (D7)
DA0: SOUND_CTRL1.2 (PA0), SOUND_GEN1.11 (DA0)
DA1: SOUND_CTRL1.3 (PA1), SOUND_GEN1.10 (DA1)
DA2: SOUND_CTRL1.4 (PA2), SOUND_GEN1.9 (DA2)
DA3: SOUND_CTRL1.5 (PA3), SOUND_GEN1.8 (DA3)
DA4: SOUND_CTRL1.6 (PA4), SOUND_GEN1.7 (DA4)
DA5: SOUND_CTRL1.7 (PA5), SOUND_GEN1.6 (DA5)
DA6: SOUND_CTRL1.8 (PA6), SOUND_GEN1.5 (DA6)
DA7: SOUND_CTRL1.9 (PA7), SOUND_GEN1.4 (DA7)
GND: C7.1, C9.1, C11.1, J1.3, LINE_OUT1.S, LINE_OUT_VOLUME1.3, LINE_OUT_VOLUME1.6, R1.2, R2.2, R3.2, R4.2, SOUND_CTRL1.1 (GND), SOUND_GEN1.1 (VSS), SOUND_GEN1.19 (VSS), SOUND_GEN1.22 (~A9), SUB_OUT1.S, SUB_VOLUME1.3, U1.7 (GND), U3.12 (GND), U5.2 (-), U5.4 (GND), U6.2 (-), U6.4 (GND), U7.2 (-), U7.4 (GND)
unnamed: C1.1, C2.1, U5.5
unnamed: C2.2, R1.1
unnamed: C3.1, C4.1, U6.5
unnamed: C4.2, R2.1
unnamed: C6.2, R3.1
unnamed: C8.1, U5.1 (GAIN)
unnamed: C8.2, U5.8 (GAIN)
unnamed: C10.1, U6.1 (GAIN)
unnamed: C10.2, U6.8 (GAIN)
unnamed: C12.1, R5.1
unnamed: C5.1, C6.1, C12.2, U7.5
unnamed: R5.2, U7.1 (GAIN)
unnamed: LINE_OUT_VOLUME1.1, SOUND_GEN1.17 (A)
unnamed: LINE_OUT_VOLUME1.4, SOUND_GEN1.15 (B)
unnamed: SOUND_GEN1.18 (C), SUB_VOLUME1.1
unnamed: U1.2 (D), U1.6 (~Q), U1.11 (C)
unnamed: U1.8 (~Q), U1.12 (D)
unnamed: LINE_OUT_VOLUME1.2, U5.3 (+)
unnamed: C7.2, U5.7 (BYPASS)
unnamed: LINE_OUT_VOLUME1.5, U6.3 (+)
unnamed: C9.2, U6.7 (BYPASS)
unnamed: SUB_VOLUME1.2, U7.3 (+)
unnamed: C11.2, U7.7 (BYPASS)
PHI2: J1.24, SOUND_CTRL1.25 (PHI2), U3.1 (CLK/IN)
R\~W: J1.37, SOUND_CTRL1.22 (R/~W)
SND_L: C3.2, LINE_OUT1.T
SND_R: C1.2, LINE_OUT1.R
SND_SUB: C5.2, R4.1, SUB_OUT1.T
VCC: J1.1, SOUND_CTRL1.20 (VCC), SOUND_CTRL1.24 (CS1), SOUND_GEN1.13 (VCC), SOUND_GEN1.23 (A8), U1.1 (~R), U1.4 (~S), U1.10 (~S), U1.13 (~R), U1.14 (VCC), U3.24 (VCC), U5.6 (V+), U6.6 (V+), U7.6 (V+)
~CS_SND: SOUND_CTRL1.23 (~CS2), SOUND_GEN1.24 (~CS), U3.14 (I/O)
~RESET: J1.18, SOUND_CTRL1.34 (~RESET), SOUND_GEN1.21 (~RESET)

Notes on the sheet:
Sound controller IRQ3 Address space: 0xD120 - 0xD12F

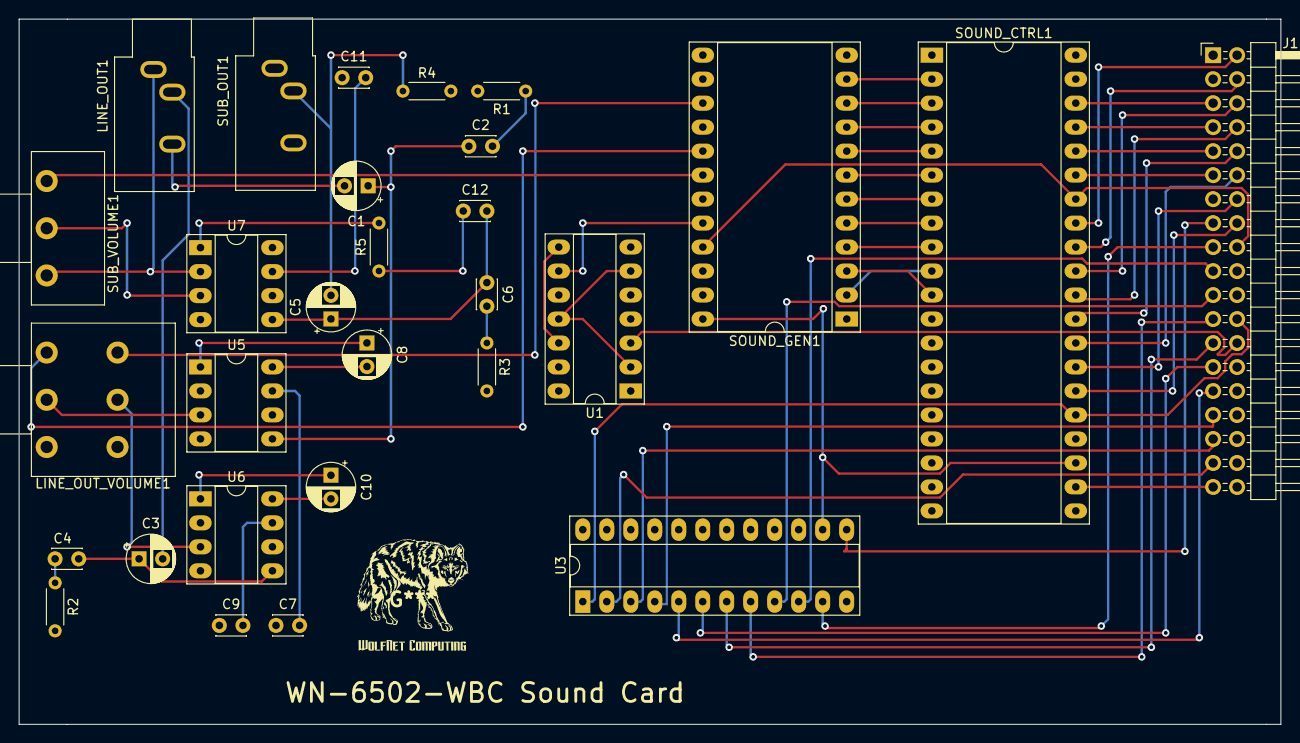
[picture p8: board Sound.kicad_pcb from above]

Board: 4 copper layers, 133.6 x 74.7 mm, 29 parts (0 on the bottom side), 67 nets.
