WolfNet-Computing/WolfNet-65C02-WBC/Debug/Debug.kicad_pcb

## KiCad design Debug/Debug.kicad_pcb (2026-08-31)

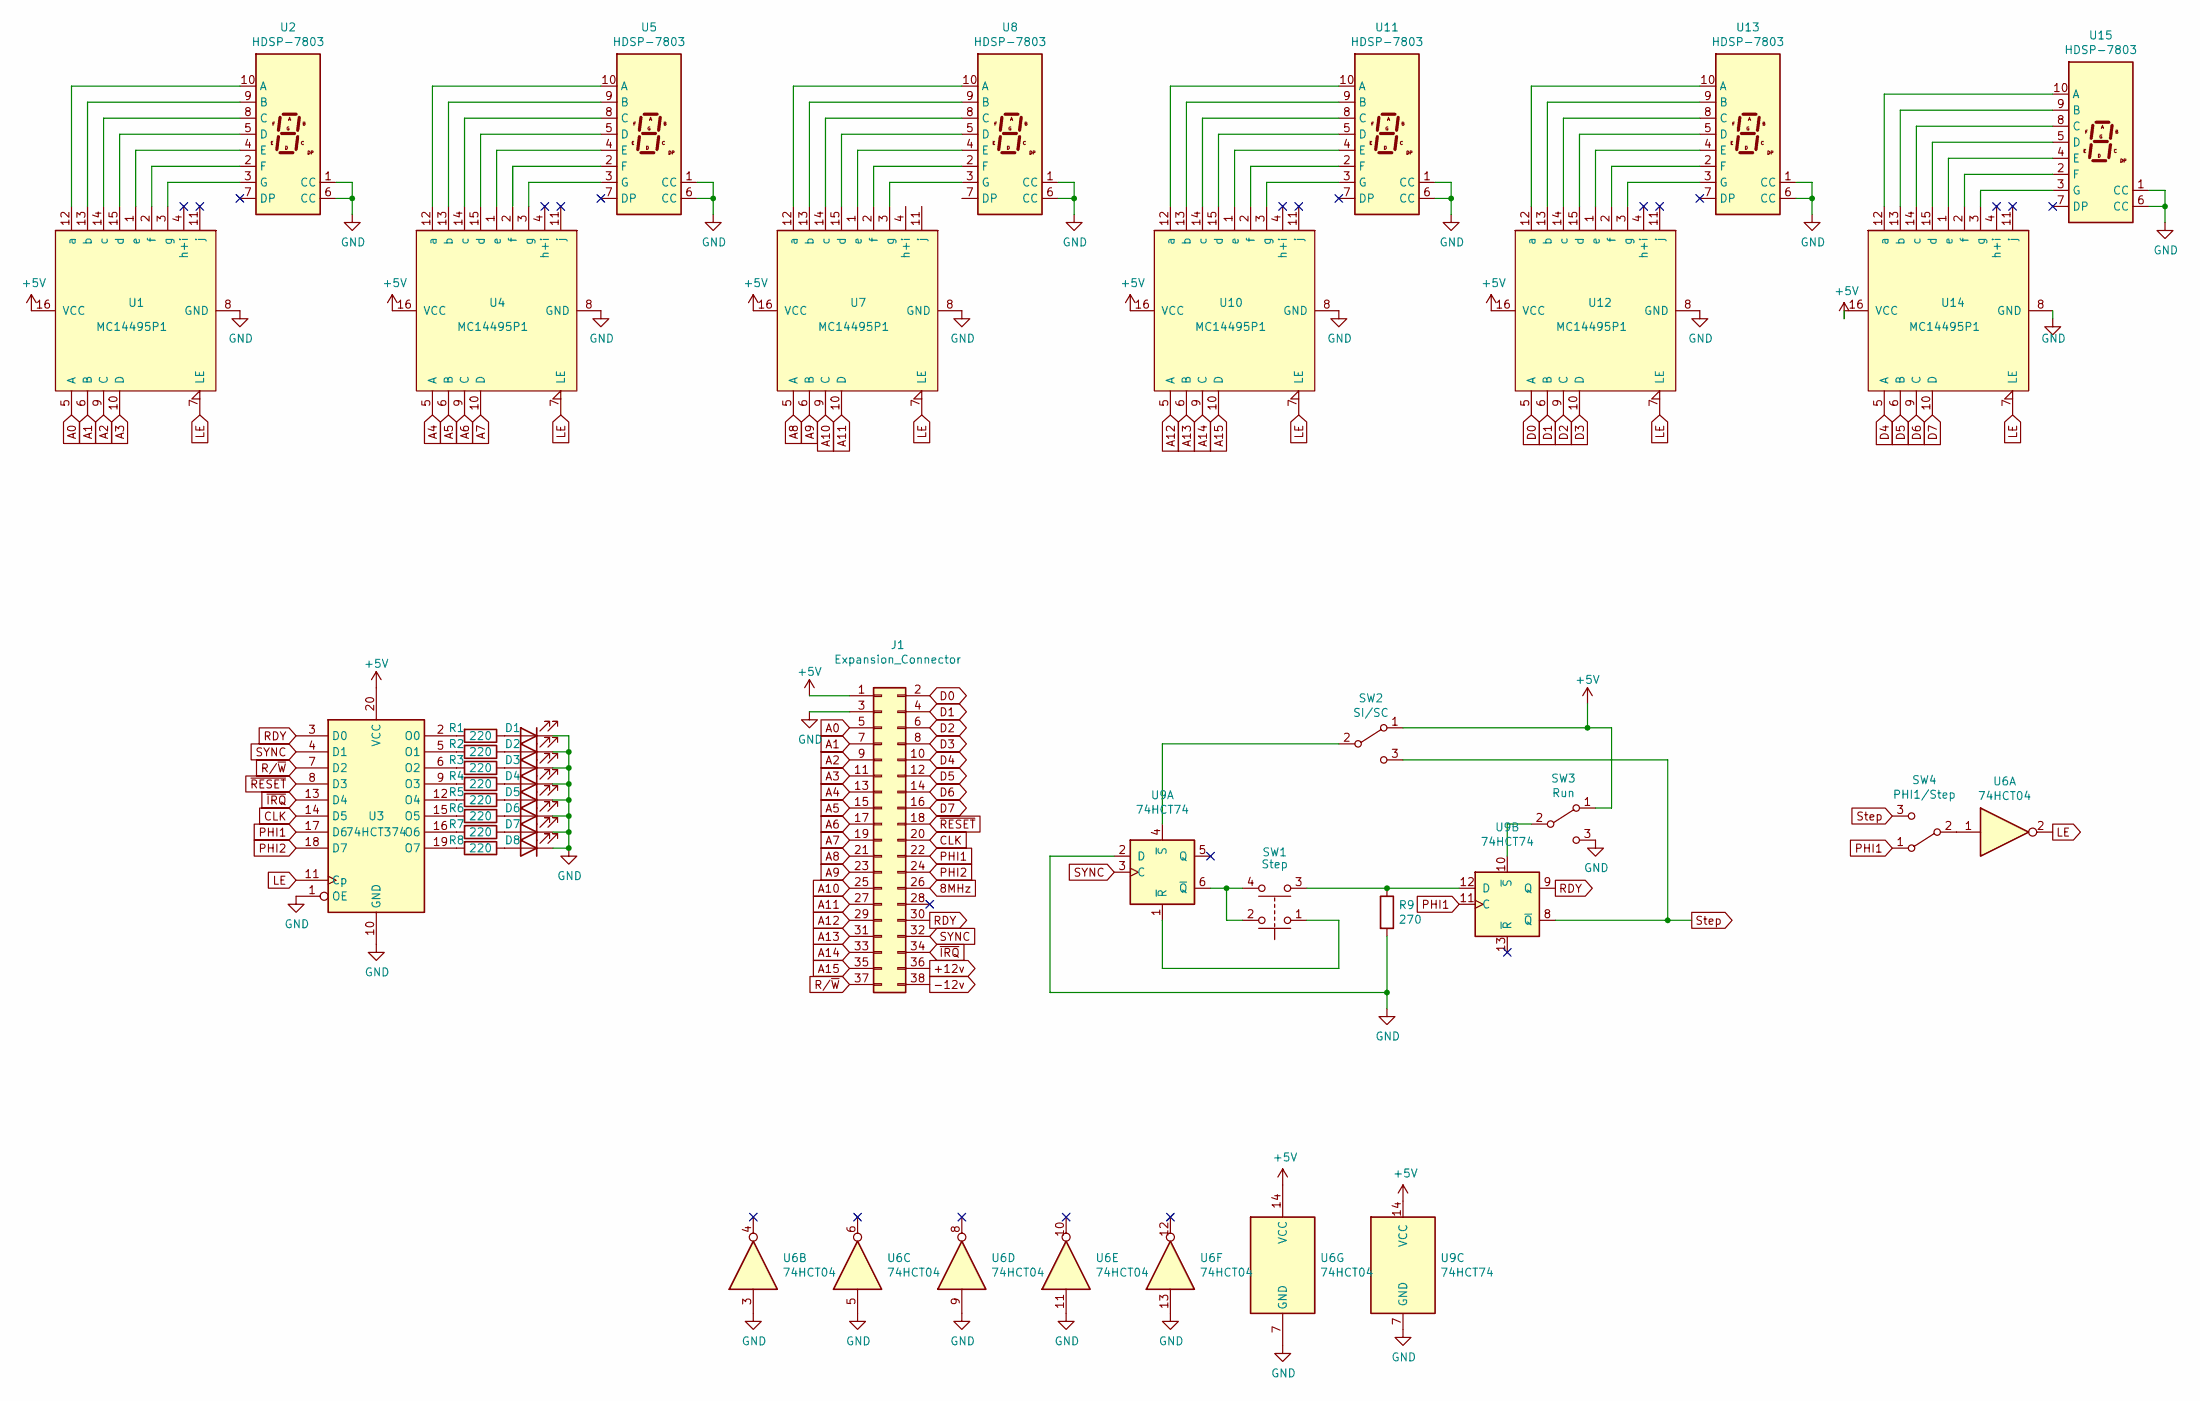
[picture p9: schematic Debug.kicad_sch, WolfNet 6502 WBC - Debug Card]

Parts:
D1: RDY; LED_D5.0mm
D2: Sync; LED_D5.0mm
D3: RW; LED_D5.0mm
D4: Reset; LED_D5.0mm
D5: IRQ; LED_D5.0mm
D6: NMI; LED_D5.0mm
D7: PHI1; LED_D5.0mm
D8: PHI2; LED_D5.0mm
J1: Expansion_Connector; PinHeader_2x19_P2.54mm_Horizontal
R1, R2, R3, R4, R5, R6, R7, R8: 220; R_Axial_DIN0207_L6.3mm_D2.5mm_P7.62mm_Horizontal
R9: 270; R_Axial_DIN0207_L6.3mm_D2.5mm_P7.62mm_Horizontal
SW1: Step; SW_Push_2P1T_Toggle_CK_PVA1xxH1xxxxxxV2
SW2: SI/SC; SW_Slide_1P2T_CK_OS102011MS2Q
SW3: Run; SW_Slide_1P2T_CK_OS102011MS2Q
SW4: PHI1/Step; SW_Slide_1P2T_CK_OS102011MS2Q
U1, U4, U7, U10, U12, U14: MC14495P1; DIP-16_W7.62mm_Socket_LongPads
U2, U5, U8, U11, U13, U15: HDSP-7803; HDSP-7801
U3: 74HCT374; DIP-20_W7.62mm_Socket_LongPads
U6: 74HCT04; DIP-14_W7.62mm_Socket_LongPads
U9: 74HCT74; DIP-14_W7.62mm_Socket_LongPads

Connections:
8MHz: J1.26
+5V: J1.1, SW2.1 (A), SW3.1 (A), U1.16 (VCC), U3.20 (VCC), U4.16 (VCC), U6.14 (VCC), U7.16 (VCC), U9.14 (VCC), U10.16 (VCC), U12.16 (VCC), U14.16 (VCC)
+12v: J1.36
-12v: J1.38
A0: J1.5, U1.5 (A)
A1: J1.7, U1.6 (B)
A2: J1.9, U1.9 (C)
A3: J1.11, U1.10 (D)
A4: J1.13, U4.5 (A)
A5: J1.15, U4.6 (B)
A6: J1.17, U4.9 (C)
A7: J1.19, U4.10 (D)
A8: J1.21, U7.5 (A)
A9: J1.23, U7.6 (B)
A10: J1.25, U7.9 (C)
A11: J1.27, U7.10 (D)
A12: J1.29, U10.5 (A)
A13: J1.31, U10.6 (B)
A14: J1.33, U10.9 (C)
A15: J1.35, U10.10 (D)
CLK: J1.20, U3.14 (D5)
D0: J1.2, U12.5 (A)
D1: J1.4, U12.6 (B)
D2: J1.6, U12.9 (C)
D3: J1.8, U12.10 (D)
D4: J1.10, U14.5 (A)
D5: J1.12, U14.6 (B)
D6: J1.14, U14.9 (C)
D7: J1.16, U14.10 (D)
GND: D1.1 (K), D2.1 (K), D3.1 (K), D4.1 (K), D5.1 (K), D6.1 (K), D7.1 (K), D8.1 (K), J1.3, R9.2, SW3.3 (C), U1.8 (GND), U2.1 (CC), U2.6 (CC), U3.1 (OE), U3.10 (GND), U4.8 (GND), U5.1 (CC), U5.6 (CC), U6.3, U6.5, U6.7 (GND), U6.9, U6.11, U6.13, U7.8 (GND), U8.1 (CC), U8.6 (CC), U9.2 (D), U9.7 (GND), U10.8 (GND), U11.1 (CC), U11.6 (CC), U12.8 (GND), U13.1 (CC), U13.6 (CC), U14.8 (GND), U15.1 (CC), U15.6 (CC)
LE: U1.7 (LE), U3.11 (Cp), U4.7 (LE), U6.2, U7.7 (LE), U10.7 (LE), U12.7 (LE), U14.7 (LE)
unnamed: D1.2 (A), R1.1
unnamed: D2.2 (A), R2.1
unnamed: D3.2 (A), R3.1
unnamed: D4.2 (A), R4.1
unnamed: D5.2 (A), R5.1
unnamed: D6.2 (A), R6.1
unnamed: D7.2 (A), R7.1
unnamed: D8.2 (A), R8.1
unnamed: SW2.2 (B), U9.4 (~S)
unnamed: SW3.2 (B), U9.10 (~S)
unnamed: SW4.2 (B), U6.1
unnamed: U1.12 (a), U2.10 (A)
unnamed: U1.13 (b), U2.9 (B)
unnamed: U1.14 (c), U2.8 (C)
unnamed: U1.15 (d), U2.5 (D)
unnamed: U1.1 (e), U2.4 (E)
unnamed: U1.2 (f), U2.2 (F)
unnamed: U1.3 (g), U2.3 (G)
unnamed: R1.2, U3.2 (O0)
unnamed: R2.2, U3.5 (O1)
unnamed: R3.2, U3.6 (O2)
unnamed: R4.2, U3.9 (O3)
unnamed: R5.2, U3.12 (O4)
unnamed: R6.2, U3.15 (O5)
unnamed: R7.2, U3.16 (O6)
unnamed: R8.2, U3.19 (O7)
unnamed: U4.12 (a), U5.10 (A)
unnamed: U4.13 (b), U5.9 (B)
unnamed: U4.14 (c), U5.8 (C)
unnamed: U4.15 (d), U5.5 (D)
unnamed: U4.1 (e), U5.4 (E)
unnamed: U4.2 (f), U5.2 (F)
unnamed: U4.3 (g), U5.3 (G)
unnamed: U7.12 (a), U8.10 (A)
unnamed: U7.13 (b), U8.9 (B)
unnamed: U7.14 (c), U8.8 (C)
unnamed: U7.15 (d), U8.5 (D)
unnamed: U7.1 (e), U8.4 (E)
unnamed: U7.2 (f), U8.2 (F)
unnamed: U7.3 (g), U8.3 (G)
unnamed: SW1.2, SW1.4, U9.6 (~Q)
unnamed: SW1.1, U9.1 (~R)
unnamed: R9.1, SW1.3, U9.12 (D)
unnamed: U10.12 (a), U11.10 (A)
unnamed: U10.13 (b), U11.9 (B)
unnamed: U10.14 (c), U11.8 (C)
unnamed: U10.15 (d), U11.5 (D)
unnamed: U10.1 (e), U11.4 (E)
unnamed: U10.2 (f), U11.2 (F)
unnamed: U10.3 (g), U11.3 (G)
unnamed: U12.12 (a), U13.10 (A)
unnamed: U12.13 (b), U13.9 (B)
unnamed: U12.14 (c), U13.8 (C)
unnamed: U12.15 (d), U13.5 (D)
unnamed: U12.1 (e), U13.4 (E)
unnamed: U12.2 (f), U13.2 (F)
unnamed: U12.3 (g), U13.3 (G)
unnamed: U14.12 (a), U15.10 (A)
unnamed: U14.13 (b), U15.9 (B)
unnamed: U14.14 (c), U15.8 (C)
unnamed: U14.15 (d), U15.5 (D)
unnamed: U14.1 (e), U15.4 (E)
unnamed: U14.2 (f), U15.2 (F)
unnamed: U14.3 (g), U15.3 (G)
PHI1: J1.22, SW4.1 (A), U3.17 (D6), U9.11 (C)
PHI2: J1.24, U3.18 (D7)
RDY: J1.30, U3.3 (D0), U9.9 (Q)
R/~W: J1.37, U3.7 (D2)
SYNC: J1.32, U3.4 (D1), U9.3 (C)
Step: SW2.3 (C), SW4.3 (C), U9.8 (~Q)
~IRQ: J1.34, U3.13 (D4)
~RESET: J1.18, U3.8 (D3)

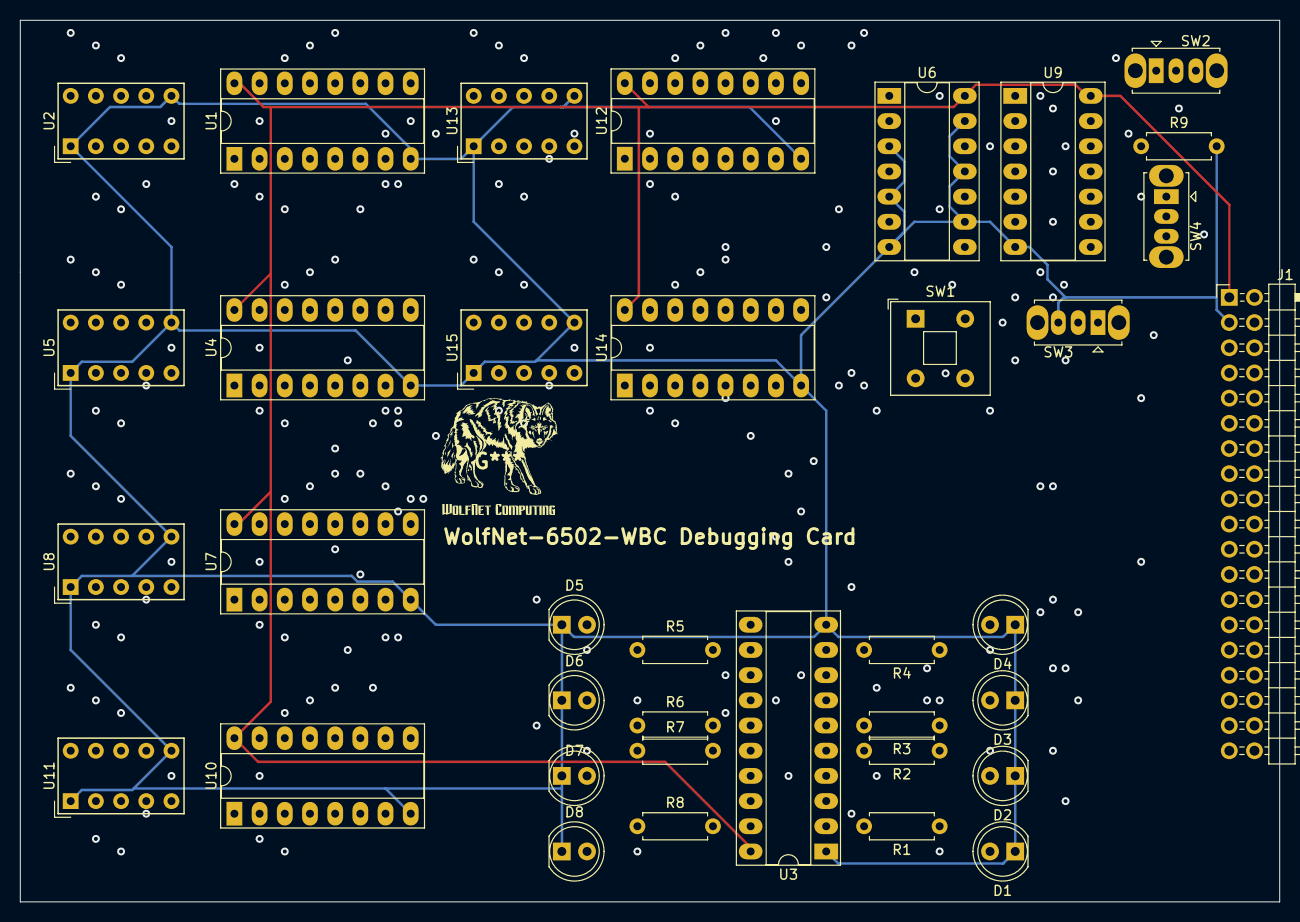
[picture p10: board Debug.kicad_pcb from above]

Board: 4 copper layers, 127.0 x 88.9 mm, 37 parts (0 on the bottom side), 100 nets.
