WolfNet-Computing/WolfNet-65C02-WBC/(commit log)

2021-08-06 First commit from Git
    [6522 VIA.kicad_pcb, 6522 VIA.sch, Baseboard and PSU.sch, CPU.kicad_pcb, CPU.sch, RAM.sch, ROM.sch, RS232.sch]
2021-08-07 Updated Serial IO to use the 6522 VIA instead of the 6521 PIA
    [Serial IO.sch]
2021-08-07 Fixed bugs...
    [6522 VIA.sch, RS232.sch]
2021-08-07 Bug fixes...
    [6522 VIA.kicad_pcb, 6522 VIA.sch]
2021-08-07 Changed name of 6522 VIA to 6522 VIA GPIO
    [6522 VIA GPIO.kicad_pcb, 6522 VIA GPIO.sch]
2021-08-09 Restored SerialIO back to 6521 PIA...
    [6522 VIA GPIO.sch, Serial IO.sch]
2021-08-14 Finished Baseboard schematic...
    [Baseboard and PSU.sch]
2021-11-13 Updated SBC...
    [6522 VIA.sch, Baseboard and PSU.sch, CPU.sch, RAM.sch, ROM.sch, RS232.sch, SBC.sch, Serial IO.sch]
2021-11-24 First commit form Git...
    [6522 VIA GPIO.kicad_pcb, 6522 VIA GPIO.sch, Baseboard and PSU.sch, CPU.kicad_pcb, CPU.sch, Motherboard.kicad_pcb, Motherboard.sch, RAM.sch]
2021-12-02 Version 1.4
    [Motherboard.csv, Motherboard.kicad_pcb, Motherboard.sch, file61B3EA8D.sch]
2021-12-04 Updated Documentation...
    [Serial IO.sch]
2021-12-05 Improved power supply...
    [Motherboard.sch, file61B3EA8D.sch]
2021-12-07 Updated library references...
    [Motherboard.csv]
2021-12-07 Added electronic fuse...
    [Motherboard.sch]
2021-12-08 Version 1.5 started...
    [Motherboard.sch]
2021-12-08 Updated footprints...
    [Motherboard.sch]
2021-12-08 Updated baseboardConnector to Expansion_Connector...
    [Motherboard.sch]
2021-12-09 Bug fixes and TODOs addressed...
    [Motherboard.sch]
2021-12-16 Edited libraries and started the layout for bank switching...
    [Motherboard.kicad_pcb, Motherboard.sch]
2021-12-27 Schematic PDF created...
2022-01-19 Updated schematic...
    [Motherboard.sch]
2022-04-19 Completed 65SIB address decoding and added annotations for parts...
    [Motherboard.kicad_pcb, Motherboard.sch]
2022-04-22 Finished routing and placement...
    [Motherboard.csv, Motherboard.kicad_pcb, Motherboard.sch]
2022-04-22 Extra routing and placement completed...
    [Motherboard.kicad_pcb, Motherboard.sch]
2022-04-22 Completed version 2 schematic...
    [Motherboard.kicad_pcb, Motherboard.sch]
2022-04-22 Various bug fixes and more traces added....
    [Motherboard.kicad_pcb, Motherboard.sch]
2022-04-23 Further bug fixes and corrections...
    [Motherboard.kicad_pcb, Motherboard.sch]
2022-04-23 Finalised 2.1 of the schematic and circuit board...
    [Motherboard.kicad_pcb, Motherboard.sch]
2022-04-23 Debugging card added...
    [Debug.sch]
2022-04-24 Fixed grounding issue...
    [Motherboard.kicad_pcb, Motherboard.sch]
2022-04-25 Updated the things...
    [Motherboard.kicad_pcb]
2022-04-25 Gerber files generated...
    [Motherboard-B_Cu.gbr, Motherboard-Edge_Cuts.gbr, Motherboard-F_Cu.gbr, Motherboard-F_Mask.gbr, Motherboard-F_Paste.gbr, Motherboard-F_SilkS.gbr, Motherboard-In1_Cu.gbr, Motherboard-In2_Cu.gbr]
2022-04-26 2.3 ON THE WAY...
    [Motherboard.kicad_pcb, Motherboard.sch]
2022-04-26 On our way to 2.3...
    [Motherboard.sch]
2022-04-27 Sound generator and memory banking added...
    [Motherboard.sch]
2022-04-27 Updated component references...
    [Motherboard.sch]
2022-04-27 Pre-annotation upload...
    [Motherboard.sch]
2022-04-27 Improvements and bug fixes...
    [Motherboard.sch]
2022-04-27 Started PCB design...
    [Motherboard.csv, Motherboard.kicad_pcb, Motherboard.sch]
2022-04-28 Separated sounds card from motherboard...
    This is only to save space on the final motherboard design.
    [Motherboard.csv, Motherboard.kicad_pcb, Sound.kicad_pcb, Sound.sch]
2022-04-28 Part way to bank switched memory...
2022-04-28 Completed schematic for 2.3...
    [Motherboard.sch]
2022-04-28 Bug fixes...
    Multiple components had the same name, this has been corrected.
    [Motherboard.sch]
2022-04-30 Bug fixes and added some traces...
    [Motherboard.kicad_pcb, Motherboard.sch]
2022-05-01 More traces added...
    [Motherboard.kicad_pcb]
2022-05-01 Added more traces...
    [Motherboard.kicad_pcb]
2022-05-01 630 odd traces left to go...
    [Motherboard.kicad_pcb]
2022-05-01 549 traces to go...
    [Motherboard.kicad_pcb]
2022-05-01 525 traces to go...
    [Motherboard.kicad_pcb, Motherboard.sch]
2022-05-01 Well on the road to 2.3...
    [Motherboard.kicad_pcb, Motherboard.sch]
2022-05-01 500 odd traces left...
    [Motherboard.kicad_pcb, Motherboard.sch]
2022-05-02 Caps, Power for gates and traces added...
    [Motherboard.csv, Motherboard.kicad_pcb, Motherboard.sch]
2022-05-02 539 traces to go...
    [Motherboard.kicad_pcb, Motherboard.sch]
2022-05-02 522 traces to go...
    [Motherboard.kicad_pcb]
2022-05-02 488 traces to go...
    [Motherboard.kicad_pcb]
2022-05-02 480 traces left to go...
    [Motherboard.kicad_pcb]
2022-05-02 A lot closer now...
    [Motherboard.csv, Motherboard.kicad_pcb, motherboard.csv]
2022-05-02 Removed some old 2.2 files...
    [Motherboard-B_Cu.gbr, Motherboard-Edge_Cuts.gbr, Motherboard-F_Cu.gbr, Motherboard-F_Mask.gbr, Motherboard-F_Paste.gbr, Motherboard-F_SilkS.gbr, Motherboard-In1_Cu.gbr, Motherboard-In2_Cu.gbr]
2022-05-02 420 traces to go...
    420! 420!! 420!!!
    [Motherboard.kicad_pcb, Motherboard.sch]
2022-05-02 202 traces until 2.3...
    [Motherboard.kicad_pcb, Motherboard.sch]
2022-05-02 168 traces to go...
    [Motherboard.kicad_pcb]
2022-05-02 156 unrouted traces...
    [Motherboard.kicad_pcb]
2022-05-03 81 more traces...
    [Motherboard.kicad_pcb]
2022-05-03 Finished routing traces...
    [Motherboard.kicad_pcb, Motherboard.sch]
2022-05-03 Final traces added and fills added...
2022-05-03 2.3 has arrived...
    2.3! 2.3!! 2.3!!!
    [Motherboard.csv, Motherboard.sch, Sound.kicad_pcb, Sound.sch]
2022-05-04 Bug fixes and shutdown button added...
    [Motherboard.sch]
2022-05-04 Updated documentation location...
    [Motherboard.sch, Sound.kicad_pcb, Sound.sch]
2022-05-04 Renamed some components...
    [Motherboard.sch]
2022-05-04 Sound card schematic completed...
    [Sound.csv, Sound.kicad_pcb, Sound.sch]
2022-05-04 Completed Sound Card...
    [Sound.csv, Sound.kicad_pcb, Sound.sch]
2022-05-04 Debug card added...
    [Debug.sch]
2022-05-04 Started video card...
    [Video.kicad_pcb, Video.sch]
2022-05-05 Updated motherboard PCB and finished sound card PCB...
    Website added to PCB design and completed sound card schematic, PCB and SVG files.
    [Sound.kicad_pcb, Sound.sch]
2022-05-06 Updated motherboard...
    [Motherboard.sch]
2022-05-06 Added wolf symbol...
    [Motherboard.sch]
2022-05-06 65C51N changed to 65C51...
    [Motherboard.sch]
2022-05-09 Road to 2.5...
    Still need to update address decoding to use 74HCT138s
    [Motherboard.kicad_sch, Motherboard.sch]
2022-05-09 2.5 schematic complete...
    [Motherboard.kicad_sch]
2022-05-09 Road to 2.5 release...
    [Motherboard.kicad_sch]
2022-05-09 Started on 2.5 PCB...
    [Motherboard.kicad_pcb, Motherboard.kicad_sch]
2022-05-10 Almost finished 2.5 placements...
    [Motherboard.kicad_pcb, Motherboard.kicad_sch, Motherboard.sch]
2022-05-10 Finished 2.5 placement...
    [Motherboard.kicad_pcb, Motherboard.kicad_sch]
2022-05-11 550 unrouted traces...
    [Motherboard.kicad_pcb, Motherboard.kicad_sch]
2022-05-11 527 unrouted traces...
    Updated documentation in HTML.
    [Motherboard.csv, Motherboard.kicad_pcb]
2022-05-11 500 unrouted traces...
    [Motherboard.kicad_pcb]
2022-05-11 485 unrouted traces...
    [Motherboard.kicad_pcb]
2022-05-11 Fat trimming...
    Trimmed out some old files and edited the docs.
    [Debug.kicad_sch, Debug.sch, Sound.csv, Sound.kicad_pcb, Sound.kicad_sch, Sound.sch, Video.kicad_pcb, Video.sch]
2022-05-11 455 unrouted traces...
    [Motherboard.kicad_pcb]
2022-05-11 412 traces left to route...
    [Motherboard.kicad_pcb]
2022-05-11 406 traces left to route...
    [Motherboard.kicad_pcb, Motherboard.kicad_sch, Sound.kicad_pcb]
2022-05-11 405 unrouted traces...
    [Motherboard.kicad_pcb, Sound.kicad_pcb, Sound.kicad_sch]
2022-05-11 357 traces left to route...
    [Motherboard.kicad_pcb]
2022-05-12 316 traces left to route...
    [Motherboard.kicad_pcb]
2022-05-12 311 traces to route...
    [Motherboard.kicad_pcb]
2022-05-12 290 unrouted traces...
    [Motherboard.kicad_pcb]
2022-05-12 286 unrouted traces...
    [Motherboard.kicad_pcb]
2022-05-12 257 unrouted traces...
    [Motherboard.kicad_pcb]
2022-05-12 247 unrouted traces...
    [Motherboard.kicad_pcb]
2022-05-12 243 unrouted traces...
    [Motherboard.kicad_pcb]
2022-05-12 239 unrouted traces...
    [Motherboard.kicad_pcb]
2022-05-12 233 unrouted traces...
    [Motherboard.kicad_pcb, Motherboard.kicad_sch]
2022-05-13 214 unrouted traces...
    [Motherboard.kicad_pcb]
2022-05-13 173 unrouted traces...
    [Motherboard.kicad_pcb]
2022-05-13 157 unrouted traces...
    [Motherboard.kicad_pcb, Motherboard.kicad_sch]
2022-05-13 149 unrouted traces...
    [Motherboard.kicad_pcb]
2022-05-14 Finished sound card...
    [Sound.kicad_pcb, Sound.kicad_sch]
2022-05-14 136 unrouted traces...
    [Motherboard.kicad_pcb]
2022-05-14 111 unrouted traces...
    [Motherboard.kicad_pcb]
2022-05-14 96 traces left to route...
    [Motherboard.kicad_pcb]
2022-05-14 92 unrouted traces...
    [Motherboard.kicad_pcb]
2022-05-15 Reduced chip count...
    [Motherboard.kicad_pcb]
2022-05-15 646 unrouted traces...
    [Motherboard.kicad_pcb]
2022-05-15 438 unrouted traces...
    [Motherboard.kicad_pcb]
2022-05-15 372 unrouted traces...
    [Motherboard.kicad_pcb, Motherboard.kicad_sch]
2022-05-15 Optimised layout...
    [Motherboard.kicad_sch]
2022-05-15 Updated layout and form factor...
    [Motherboard.kicad_pcb]
2022-05-15 298 unrouted traces...
    [Motherboard.kicad_pcb]
2022-05-15 246 unrouted traces...
    [Motherboard.kicad_pcb]
2022-05-15 226 unrouted traces...
    [Motherboard.kicad_pcb]
2022-05-15 192 unrouted traces...
    [Motherboard.kicad_pcb]
2022-05-15 Updated iBOM and version...
    [Motherboard.kicad_pcb, Motherboard.kicad_sch]
2022-05-16 203 unrouted traces...
    [Motherboard.kicad_pcb]
2022-05-16 153 unrouted traces...
    [Motherboard.kicad_pcb]
2022-05-16 150 unrouted traces...
    [Motherboard.kicad_pcb, Motherboard.kicad_sch]
2022-05-16 114 unrouted traces...
    [Motherboard.kicad_pcb]
2022-05-16 110 unrouted traces...
    [Motherboard.kicad_pcb]
2022-05-16 104 unrouted traces...
    [Motherboard.kicad_pcb, Motherboard.kicad_sch]
2022-05-16 100 unrouted traces...
    [Motherboard.kicad_pcb]
2022-05-16 78 unrouted traces...
    [Motherboard.kicad_pcb]
2022-05-16 69 unrouted traces...
    [Motherboard.kicad_pcb]
2022-05-16 43 unrouted traces...
    [Motherboard.kicad_pcb]
2022-05-16 Updated worksheet...
    [Sound.kicad_pcb, Sound.kicad_sch]
2022-05-17 16 unrouted traces...
    [Motherboard.kicad_pcb]
2022-05-17 Completed version 2.6...
    [Motherboard.kicad_pcb, Motherboard.kicad_sch]
2022-05-17 Finished sound card 1.2...
    [Sound.kicad_pcb, Sound.kicad_sch]
2022-05-17 Added prototyping card...
    [Prototyping.kicad_pcb, Prototyping.kicad_sch]
2022-05-17 Updated debug card...
    [Debug.kicad_sch]
2022-05-18 Debug card layout completed...
    [Debug.kicad_pcb, Debug.kicad_sch]
2022-05-18 Prototyping updated...
    [Prototyping.kicad_sch]
2022-05-18 6 unrouted traces...
    [Motherboard.kicad_pcb]
2022-05-18 Version 2.6 completed...
    [Motherboard.kicad_pcb, Motherboard.kicad_sch]
2022-05-18 Prototyping card updated...
    [Prototyping.kicad_pcb]
2022-05-18 98 unrouted traces...
    [Debug.kicad_pcb, Debug.kicad_sch]
2022-05-18 Logo added...
    [Sound.kicad_pcb]
2022-05-18 90 unrouted traces...
    [Debug.kicad_pcb]
2022-05-20 Completed 2.7...
    [Motherboard.kicad_pcb, Motherboard.kicad_sch]
2022-05-20 64 unrouted traces...
    [Debug.kicad_pcb, Debug.kicad_sch]
2022-05-21 59 unrouted traces...
    [Debug.kicad_pcb]
2022-05-21 45 unrouted traces...
    [Debug.kicad_pcb]
2022-05-21 36 unrouted traces...
    [Debug.kicad_pcb]
2022-05-21 Completed debugging card...
    [Debug.kicad_pcb]
2022-05-21 Finished routing traces on motherboard...
    [Motherboard.kicad_pcb]
2022-05-24 Video card added...
    [Video.kicad_sch]
2022-05-24 Added reference files...
    [basic_dump.txt, memory_map.ods]
2022-05-26 Added components...
    [Video.kicad_sch]
2022-05-27 Updated motherboard and video card schematics...
    [Motherboard.kicad_sch, Video.kicad_sch]
2022-06-27 Updated to include BS 3939 compliance...
    [Motherboard.kicad_sch]
2022-08-15 Updated to fit some standard I can't recall...
    [Motherboard.kicad_pcb, Motherboard.kicad_sch, Sound.kicad_pcb, Sound.kicad_sch]
2022-09-10 Updated file locations...
    [Sound.kicad_sch]
2022-10-27 Create Motherboard.kicad_sch-bak
2022-11-01 Moved files to KiCAD-Libraries...
2026-08-31 Update to latest KiCad version and other edits.
    Updated the files formatting to conform to KiCad 10 standards, updated dates and corrected company name, also first signed commit to this repository.
2026-09-01 Remove duplicate PCB entry; clear designators
    Remove a redundant Debug.kicad_pcb project/window entry from Debug/Debug.kicad_prl and reset "used_designators" in Debug/Debug.kicad_pro from "#PWR36" to an empty string to clear leftover designator metadata.
