WolfNet-Computing/WolfNet-65C02-WBC/(notices)

Notices in the files:
Motherboard/Motherboard.kicad_pcb:
Released for FREE under the Solderpad Hardware License v2.1
